cej830/STM32_BLDC_ESC_Firmware/docs/portfolio/author-inputs.md

# 추가 자료와 작성자 입력란

GitHub README는 프로젝트의 구성·동작·결과를 안내합니다. 개인 경험과 취업용 소개는 Notion에 별도로 정리할 수 있습니다. 이 문서는 README에 보완할 자료를 모으는 작성용 문서입니다. 공란은 확인 전까지 그대로 두며, 새 실험은 필수가 아닙니다.

## 1. 대표 사진과 Demo

**사용 위치:** 첫 화면. 만든 보드와 실제 구동을 빠르게 보여주는 자료입니다.

- 실물 사진 파일 또는 경로: ______
- 영상 파일 또는 링크: ______
- 촬영한 보드 버전·날짜: ______
- 영상의 CCR·전원·운전 조건: ______

보드와 모터가 함께 보이는 사진 한 장, 기동 후 노브로 속도를 변경하는 짧은 영상이면 시작할 수 있습니다. RPM을 측정하지 않았다면 속도 변화만 설명합니다.

## 2. PCB·회로와 설계 판단

**사용 위치:** Hardware / System Architecture. 부품 목록에서 더 나아가 설계 의도와 연결 관계를 설명합니다.

- 공개할 KiCad 프로젝트 버전: ______
- 현재 실물 패치가 반영되었는지: ______
- PCB 상·하면 이미지 / 회로도 PDF: ______
- 4층 PCB를 선택한 이유: ______
- 전력 경로·센싱·MCU 배치에서 신경 쓴 부분: ______
- Block diagram에 추가할 신호명·측정점: ______

기존 레이아웃에서 직접 설명할 수 있는 부분만 적습니다. 당시 판단하지 않은 설계 이유를 사후에 만들어 넣지 않습니다.

## 3. USB 문제 해결 증빙

**사용 위치:** Engineering Challenges 1. 풋프린트 오류를 어떻게 식별했는지 구체화합니다.

- MOSFET 부품 번호 / 참조 번호: ______
- 잘못 대응된 핀과 패드: ______
- 오류 확인 방법·관측 내용: ______
- 패치 전후 사진 / 회로 표시: ______
- 적용 후 확인한 연결·리셋 조건: ______

기억나지 않는 조건은 미기록으로 남깁니다. 테스트하지 않은 PC·운영체제에서의 동작을 추가하지 않습니다.

## 4. 고듀티 ZC 문제 해결 증빙

**사용 위치:** Engineering Challenges 2. 입력 파형과 비교기 에지 변화의 관계를 보여줍니다.

- 제거한 Vcom 커패시터 참조 번호·용량: ______
- 변경 전 파형 / 변경 후 파형: ______
- 각 채널 신호와 측정 기준점: ______
- 전원·CCR·모터 조건, 시간·전압 축: ______
- 당시 사용한 firmware 버전 또는 시점: ______

기존 사진이 있다면 먼저 사용합니다. 새로 촬영하면 과거 시험 증거가 아닌 새 시험으로 날짜를 구분합니다. 비교기 에지와 실제 정류 시점을 함께 기록할 수 있으면 제어 흐름 설명에 도움이 됩니다.

## 5. 시험 결과와 로그

**사용 위치:** Test Results. 현재 관찰 기록에 자료를 연결합니다.

- CCR 1750 구동 영상·로그: ______
- 약 1분 운전·PSU 0.6A 표시의 기록 유무: ______
- 당시 초기 온도·측정 온도: ______
- 대표 Monitor 화면 / CSV: ______
- 외부 타코미터 RPM 기록 유무: ______

기록이 없으면 현재 README처럼 개발자 관찰·PSU 표시값으로 유지합니다. 전류 측정 정확도가 확인되기 전에는 션트 CSV를 정확한 전류 성능의 증거로 쓰지 않습니다.

## 6. 빌드와 보드 버전

**사용 위치:** Repository Structure에서 연결하는 재현 문서. 소스와 실제 보드의 대응을 남깁니다.

| 항목 | 사용자 입력 |
| --- | --- |
| STM32CubeIDE 버전 | ______ |
| Compiler / toolchain 버전 | ______ |
| 프로젝트 import·build 절차 | ______ |
| 프로그래머 / 연결 핀 | ______ |
| 보드 revision / 실물 패치 목록 | ______ |
| 시험 firmware commit 또는 보존 파일 | ______ |
| 빌드·다운로드 재현 확인 여부 | ______ |

## 7. References

**사용 위치:** README References 및 상세 문서. 실제 참고한 자료만 기재합니다.

| 자료 | 제목·URL 입력 | 참고 범위 |
| --- | --- | --- |
| MCU 학습 책·블로그 | ______ | 클럭·전원·USB·리셋 주변회로 |
| BLDC ESC 제작 영상·회로 | ______ | 인버터·BEMF·초기 부품 선정 |
| 부품 데이터시트 | ______ | Buck·LDO 등의 예제 회로·배치 |
| TI 평가보드 | ______ | Gerber·PCB 레이아웃 |

## 선택적으로 더할 내용

- **PWM·ADC 동기화 그림:** TIM1 PWM, CH4 trigger, ADC 취득 위치를 한 그림에 표시하면 샘플링 전환 설명에 도움이 됩니다. 사용 가능한 자료: ______
- **기동 상태 전이 로그:** open-loop부터 폐루프 전환까지의 기록이 있으면 Firmware & Control Flow를 보강할 수 있습니다. 자료: ______
- **상용 ESC 비교:** 같은 RPM·초기 온도·운전 시간에서 비교한 결과가 생기면 후속 시험으로 추가합니다. 현재는 미수행으로 유지합니다. 자료: ______

위 항목은 세 번째 문제 해결 사례를 억지로 만들기 위한 목록이 아닙니다. 현재 두 사례로도 구성이 가능하며, 증거와 설명이 있는 항목만 추가합니다.
