cej830/STM32_BLDC_ESC_Firmware/Images/Scope/High Duty.png

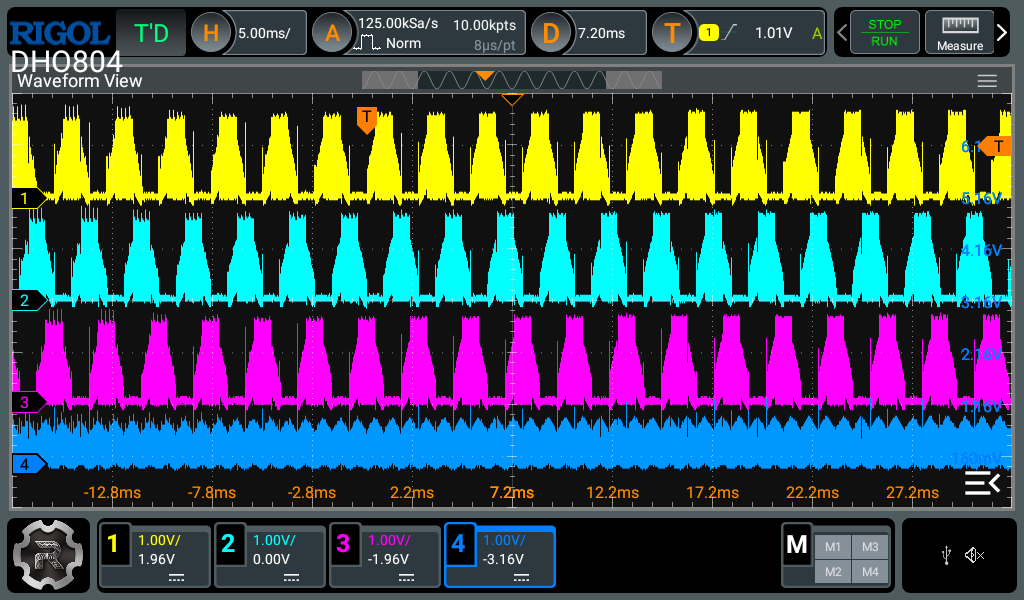
Images/Scope/High Duty.png
