cej830/STM32_BLDC_ESC_Firmware/Images/Scope/Low Duty.png

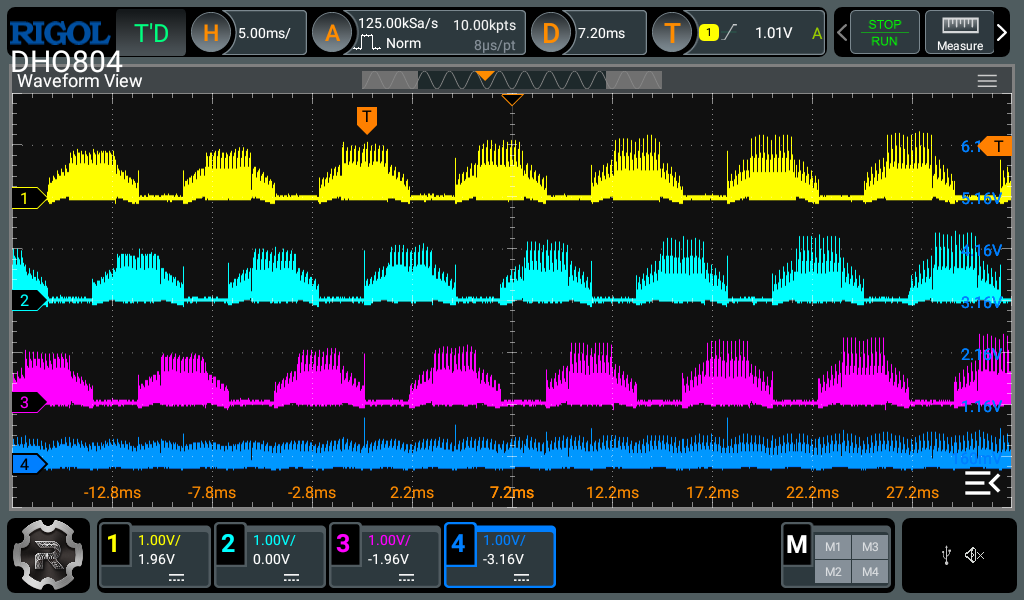
Images/Scope/Low Duty.png
