cej830/STM32_BLDC_ESC_Firmware/Images/Scope/monitor 1400.PNG

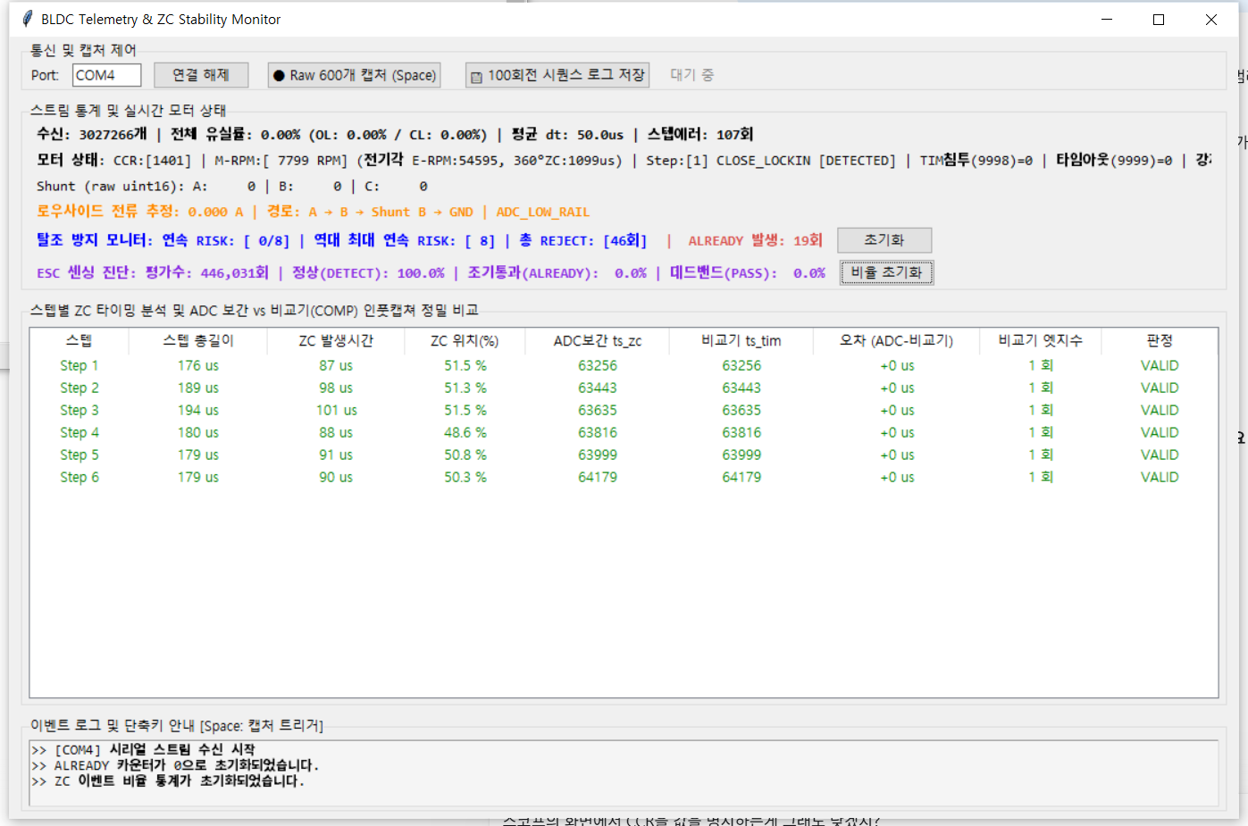
Images/Scope/monitor 1400.PNG
