cej830/STM32_BLDC_ESC_Firmware/HardWare/Manufacturer/STM32_ESC_HW_BOM.csv

# | PKG | Reference | Value | 설명 | Part number | Manufacturer | Qty | Footprint | DNP | Exclude from BOM | Exclude from Board
1 | SMD_D6.3xL7.7mm | C2 | 100uF(AEC) | Aluminum Electrolytic, 100uF, 35V, Low ESR | RVT1V101M0607 | Honor Elec | 1 | Capacitor_SMD:CP_Elec_6.3x7.7
2 | SMD_1206 | C5 | 2.2uF(3216M) | MLCC, 2.2uF, 50V, X7R, ±10% | GRM31CR71H225KA88L | Murata Electronics | 1 | Capacitor_SMD:C_1206_3216Metric
3 | SMD_1206 | C9 | 22uF(3216M) | MLCC, 22uF, 10V, X7R, ±10% | GRM31CR71A226KE15L | Murata Electronics | 1 | Capacitor_SMD:C_1206_3216Metric
4 | SMD_0603 | C14 | 10nF(1608M) | MLCC, 10nF, 50V, X7R, ±10% | CL10B103KB8NNNC | Samsung Electro-Mechanics | 1 | Capacitor_SMD:C_0603_1608Metric
5 | SMD_0805 | C19 | 10uF(2012M) | MLCC, 10uF, 25V, X5R, ±10% | CL21A106KAYNNNE | Samsung Electro-Mechanics | 1 | Capacitor_SMD:C_0805_2012Metric
6 | SMD_D8_L10.2mm | C24 | 220uF(AEC) | Aluminum Electrolytic, 220uF, 35V, Low ESR | RVT1V221M0810 | Honor Elec | 1 | Capacitor_SMD:CP_Elec_8x10.5
7 | SMD_0603 | C1,C3,C6,C8,C11,C13,C15,C17,C25,C26,C27,C31,C32,C33,C34,C35,C39,C40,C41,C42 | 100nF(1608M) | MLCC, 100nF, 50V, X7R, ±10% | GRM188R71H104KA93D | Murata Electronics | 20 | Capacitor_SMD:C_0603_1608Metric
8 | SMD_0603 | C10,C12 | 20pF(1608M) | MLCC, 20pF, 50V, C0G, ±5% | CL10C200JB8NNNC | Samsung Electro-Mechanics | 2 | Capacitor_SMD:C_0603_1608Metric
9 | SMD_0603 | C20,C36,C37,C38 | 1nF(1608M) | MLCC, 1nF, 50V, X7R, ±10% | CL10B102KB8NNNC | Samsung Electro-Mechanics | 4 | Capacitor_SMD:C_0603_1608Metric
10 | SMD_0805 | C21,C22,C23 | 1uF(2012M) | MLCC, 1uF, 25V, X5R, ±10% | CL21B105KAFNFNE | Samsung Electro-Mechanics | 3 | Capacitor_SMD:C_0805_2012Metric
11 | SMD_0603 | C28,C29,C30 | 2.2nF(1608M) | MLCC, 2.2nF, 50V, X7R, ±10% | CL10B222KB8NNNC | Samsung Electro-Mechanics | 3 | Capacitor_SMD:C_0603_1608Metric
12 | SMD_0603 | C4,C7,C16,C18 | 1uF(1608M) | MLCC, 1uF, 25V, X5R, ±10% | CL10A105KA8NNNC | Samsung Electro-Mechanics | 4 | Capacitor_SMD:C_0603_1608Metric
13 | SMD_0603 | D1 | GREEN@5mA | LED, Green, Vf 2.6-3.6V, 20mA, 900mcd | NCD0603G1 | Foshan NationStar Optoelectronics | 1 | LED_SMD:LED_0603_1608Metric
14 | SMD_0603 | D2 | RED@5mA | LED, Red, Vf 1.6-2.6V, 25mA, 220mcd | NCD0603R1 | Foshan NationStar Optoelectronics | 1 | LED_SMD:LED_0603_1608Metric
15 | SMD_0603 | D3 | YELLOW@5mA | LED, Yellow, Vf 1.6-2.6V, 25mA, 60mcd | NCD0603C1 | Foshan NationStar Optoelectronics | 1 | LED_SMD:LED_0603_1608Metric
16 | SMD_0603 | D4 | ORANGE@5mA | LED, Orange, Vf 1.5-2.6V, 25mA, 250mcd | NCD0603O1 | Foshan NationStar Optoelectronics | 1 | LED_SMD:LED_0603_1608Metric
17 | SMD_SOD-323 | D5,D6,D7 | 1SS404 | Scohotty Diode, Vf 0.45V, 300mA, 20V | 1SS404 | Jiangsu Changjing Electronics Technology Co., Ltd. | 3 | Diode_SMD:D_SOD-323
18 | SMD_9.7x5mm | F1 | 0154002.DRT | SMD Fuse with Holder, 2A, 125V, Slow-Blow | 0154002.DRT | Littelfuse | 1 | my_lib:FUSE_154 Series OMNI-BLOK® Fuse and Holder Assembly
19 |  | H1,H2,H3,H4 | MountingHole_Pad | Mounting Hole with connection |  |  | 4 | MountingHole:MountingHole_3.2mm_M3_DIN965_Pad |  | BOM에서 제외됨
20 | TH_Pitch2.54mm_1x4P | J1 | UART | Pin Header, 1x4P, 2.54mm, Male, Vertical | 254PZ-1x4P-V | LXWCONN | 1 | Connector_PinHeader_2.54mm:PinHeader_1x04_P2.54mm_Vertical
21 | SMD_Mini-B | J2 | USB_B_Mini | USB 2.0 Mini-B Receptacle, Female, SMD, Right Angle | 920-462A2021S10101 | Jing Extension of the Electronic Co. | 1 | my_lib:USB_Mini B 920-462A2021S10101
22 | TH_Pitch5.00mm_2P | J3 | PWR | Terminal Block, 2-Pos, Horizontal, 16A, 12-30AWG | 691137710002 | Würth Elektronik | 1 | my_lib:TERM BLK 2POS SIDE ENTRY 5MM PCB
23 | TH_Pitch5.00mm_2P | J4 | Phase A | Terminal Block, 2-Pos, Horizontal, 16A, 12-30AWG | 691137710002 | Würth Elektronik | 1 | my_lib:TERM BLK 2POS SIDE ENTRY 5MM PCB
24 | TH_Pitch5.00mm_2P | J5 | Phase B | Terminal Block, 2-Pos, Horizontal, 16A, 12-30AWG | 691137710002 | Würth Elektronik | 1 | my_lib:TERM BLK 2POS SIDE ENTRY 5MM PCB
25 | TH_Pitch5.00mm_2P | J6 | Phase C | Terminal Block, 2-Pos, Horizontal, 16A, 12-30AWG | 691137710002 | Würth Elektronik | 1 | my_lib:TERM BLK 2POS SIDE ENTRY 5MM PCB
26 | TH_Pitch2.54mm_1x5P | J7 | Conn_01x05 | Pin Header, 1x5P, 2.54mm, Male, Vertical | 2.54-1*5 | ZHOURI | 1 | Connector_PinHeader_2.54mm:PinHeader_1x05_P2.54mm_Vertical
27 | SMD_6x6mm | L1 | 18uH @SMNR6028-180MT | Shielded Power Inductor, 18uH, ±20%, Isat 1.52A, Irms 1.45A, DCR 169mΩ | SMNR6028-180MT | SXN(Shun Xiang Nuo Elec) | 1 | my_lib:Inductor SMNR6028-180MT
28 | SMD_SOT-23 | Q1 | UMW AO3401A (PMOS) | P-MOSFET transistor, gate/source/drain | AO3401A | UMW(Youtai Semiconductor Co., Ltd.) | 1 | Package_TO_SOT_SMD:SOT-23
29 | SMD_0603 | R2 | 1.8k(1608M) | Thick Film Resistor, 1.8kΩ, 1/10W, ±1% | 0603WAJ0182T5E | UNI-ROYAL(Uniroyal Elec) | 1 | Resistor_SMD:R_0603_1608Metric
30 | SMD_0603 | R6 | 88.7k(1608M) | Thick Film Resistor, 88.7kΩ, 1/10W, ±1% | 0603WAF8872T5E | UNI-ROYAL(Uniroyal Elec) | 1 | Resistor_SMD:R_0603_1608Metric
31 | SMD_0603 | R7 | 22.1k(1608M) | Thick Film Resistor, 22.1kΩ, 1/10W, ±1% | 0603WAF2212T5E | UNI-ROYAL(Uniroyal Elec) | 1 | Resistor_SMD:R_0603_1608Metric
32 | SMD_0603 | R9 | 0(1608M) | Thick Film Resistor, 0Ω, 1/10W, ±1% | 0603WAF0000T5E | UNI-ROYAL(Uniroyal Elec) | 1 | Resistor_SMD:R_0603_1608Metric
33 | SMD_0603 | R57 | 1.5k(1608M) | Thick Film Resistor, 1.5kΩ, 1/10W, ±1% | 0603WAF1501T5E | UNI-ROYAL(Uniroyal Elec) | 1 | Resistor_SMD:R_0603_1608Metric
34 | SMD_0603 | R1,R59 | 330(1608M) | Thick Film Resistor, 330Ω, 1/10W, ±1% | 0603WAF3300T5E | UNI-ROYAL(Uniroyal Elec) | 2 | Resistor_SMD:R_0603_1608Metric
35 | SMD_0603 | R10,R11,R12 | 33(1608M) | Thick Film Resistor, 33Ω, 1/10W, ±1% | 0603WAF330JT5E | UNI-ROYAL(Uniroyal Elec) | 3 | Resistor_SMD:R_0603_1608Metric
36 | SMD_0603 | R16,R19,R23 | 2k(1608M) | Thick Film Resistor, 2kΩ, 1/10W, ±1% | 0603WAF2001T5E | UNI-ROYAL(Uniroyal Elec) | 3 | Resistor_SMD:R_0603_1608Metric
37 | SMD_0603 | R17,R18,R27,R28,R32,R33 | 47(1608M) | Thick Film Resistor, 47Ω, 1/10W, ±1% | 0603WAF470JT5E | UNI-ROYAL(Uniroyal Elec) | 6 | Resistor_SMD:R_0603_1608Metric
38 | SMD_2512 | R22,R31,R36 | 10m(6332M) | Current Sense Metal Film Resistor, 10mΩ, 2W, ±1%, ±50ppm/℃ | PE2512FKE7W0R01Z | YAGEO | 3 | my_lib:Shunt_R_PE2512_7m-910m Ohm_SMD_2512
39 | SMD_0603 | R3,R4,R5 | 270(1608M) | Thick Film Resistor, 270Ω, 1/10W, ±5% | 0603WAJ0271T5E | UNI-ROYAL(Uniroyal Elec) | 3 | Resistor_SMD:R_0603_1608Metric
40 | SMD_0603 | R41,R42,R43 | 1k(1608M) | Thick Film Resistor, 1kΩ, 1/10W, ±1% | 0603WAF1001T5E | UNI-ROYAL(Uniroyal Elec) | 3 | Resistor_SMD:R_0603_1608Metric
41 | TH_ALPS_RK09K | R48,R50 | 10k(pot THT) | Rotary Potentiometer, 10kΩ, ±20%, Linear , Top Adjust, TH | RK09K1130AAU | ALPSALPINE | 2 | my_lib:Potentiometer_Alps_RK09K_Single_Vertical
42 | SMD_0603 | R53,R54,R55,R56 | 22(1608M) | Thick Film Resistor, 22Ω, 1/10W, ±1% | 0603WAF220JT5E | UNI-ROYAL(Uniroyal Elec) | 4 | Resistor_SMD:R_0603_1608Metric
43 | SMD_0603 | R8,R13,R14,R15,R20,R21,R24,R25,R26,R29,R30,R34,R35,R37,R38,R39,R40,R44,R45,R46,R47,R49,R51,R52,R58 | 10k(1608M) | Thick Film Resistor, 10kΩ, 1/10W, ±1% | 0603WAF1002T5E | UNI-ROYAL(Uniroyal Elec) | 25 | Resistor_SMD:R_0603_1608Metric
44 | SMD_4P_6x6mm | SW1,SW2,SW3 | SW_SPST | Tactile Switch, SPST, 12V 50mA, 1.6N, H=5mm | UK-B0228-G5-160-JZ | USAKRO | 3 | my_lib:Button_Switch_SMD SW_Push_1P1T SMD-4P,6x6mm
45 | TH_3.2mm | TP12 | 5121 G | Test Ring, Green | RH-5121 | ronghe | 1 | TestPoint:TestPoint_Keystone_5005-5009_Compact
46 | TH_3.2mm | TP1,TP2,TP3,TP4 | 5006 Blk | Test Ring, Black | RH-5006 | ronghe | 4 | TestPoint:TestPoint_Keystone_5005-5009_Compact
47 | TH_3.2mm | TP10,TP14,TP17 | 5008 Or | Test Ring, Orange,Test Ring, Red | RH-5005,RH-5008 | ronghe | 3 | TestPoint:TestPoint_Keystone_5005-5009_Compact
48 | TH_3.2mm | TP11,TP15,TP18 | 5009 Y | Test Ring, Red,Test Ring, Yellow | RH-5005,RH-5009 | ronghe | 3 | TestPoint:TestPoint_Keystone_5005-5009_Compact
49 | TH_3.2mm | TP5,TP6,TP7,TP8 | TestPoint@(5122 B) | Test Ring, Blue | RH-5122 | ronghe | 4 | TestPoint:TestPoint_Keystone_5005-5009_Compact
50 | TH_3.2mm | TP9,TP13,TP16 | 5005 R | Test Ring, Red | RH-5005 | ronghe | 3 | TestPoint:TestPoint_Keystone_5005-5009_Compact
51 | SMD_SMB(DO-214AA) | TVS1 | SMBJ13A | TVS Diode, Unidirectional, Vrwm 13V, Vbr 15.2V, Vcl 27.2V, 4kW | SMBJ13A-TR | STMicroelectronics | 1 | my_lib:TVS_Diode_SMD_SMB(DO-214AA)
52 | SMD_SOT-23-5 | U1 | TPS7A2033PDBVR | LDO Regulator, Fixed 3.3V, Vin max 6V, 300mA, Vdrop 140mV | TPS7A2033PDBVR | Texas Instruments | 1 | Package_TO_SOT_SMD:SOT-23-5
53 | SMD_SOT-23-6 | U2 | TPS560430XDBVR | Buck Converter, Adj, Vin 4-36V, 600mA, 1.1MHz | TPS560430XDBVR | Texas Instruments | 1 | my_lib:SOT-23-6(2.90 mm × 1.60 mm)
54 | SMD_LQFP-48 | U3 | STM32F103C8Tx | MCU, ARM Cortex-M3, 32bit, 72MHz, 64KB Flash, 20KB SRAM | STM32F103C8T6 | STMicroelectronics | 1 | Package_QFP:LQFP-48_7x7mm_P0.5mm
55 | SMD_TSSOP-20 | U4 | DRV8300DPWR | Gate Driver, 3-Phase BLDC, 100V, 750mA/1.5A Source/Sink, 5V-20V VDD | DRV8300DPWR | Texas Instruments | 1 | my_lib:DRV8300DPWR 20-TSSOP 6.6mm _ 4.5mm
56 | SMD_SOIC-8 | U11,U12 | TLV3202AIDR | Dual Comparator, 2.7-5V, 40ns High Speed, Push-Pull, Rail-to-Rail | TLV3202AIDR | Texas Instruments | 2 | Package_SO:SOIC-8_3.9x4.9mm_P1.27mm
57 | SMD_SOT-23-5 | U13,U14,U15 | INA180A3 | Current Sense Amplifier, Gain 100V/V, CMRR 100dB, 2.7V-5.5V | INA180A3IDBVR | Texas Instruments | 3 | Package_TO_SOT_SMD:SOT-23-5
58 | SMD_SOT-23-6 | U16,U17 | USBLC6-2SC6 | TVS Diode Array, 2-Channel Vrwm 5V, Vbr 6V, Vcl 15V, 150W | USBLC6-2SC6 | UMW(Youtai Semiconductor Co., Ltd.) | 2 | Package_TO_SOT_SMD:SOT-23-6
59 | SMD_PQFN5x6-8 | U5,U6,U7,U8,U9,U10 | IRFH7440TRPBF | N-Channel MOSFET, 40V, 1.8mΩ@10V, Qg 96nC | IRFH7440TRPBF | Infineon Technologies | 6 | Package_DFN_QFN:PQFN-8-EP_6x5mm_P1.27mm_Generic
60 | SMD_HC-49S | Y1 | 8MHz @ 20pF | Crystal, 8MHz, 20pF, ±20ppm, ESR 70Ω | X49SM8MSD2SC | YXC Crystal Oscillators | 1 | Crystal:Crystal_SMD_HC49-SD
