cej830/STM32_BLDC_ESC_Firmware/Images/Demo/motor-operation.jpg

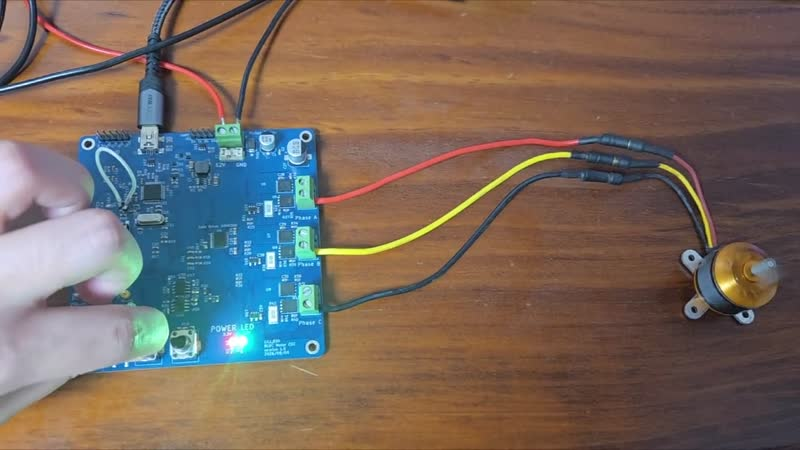
Images/Demo/motor-operation.jpg
