cej830/STM32_BLDC_ESC_Firmware/HardWare/STM32_ESC_HW.kicad_pcb

## KiCad design HardWare/STM32_ESC_HW.kicad_pcb (2026-10-27)

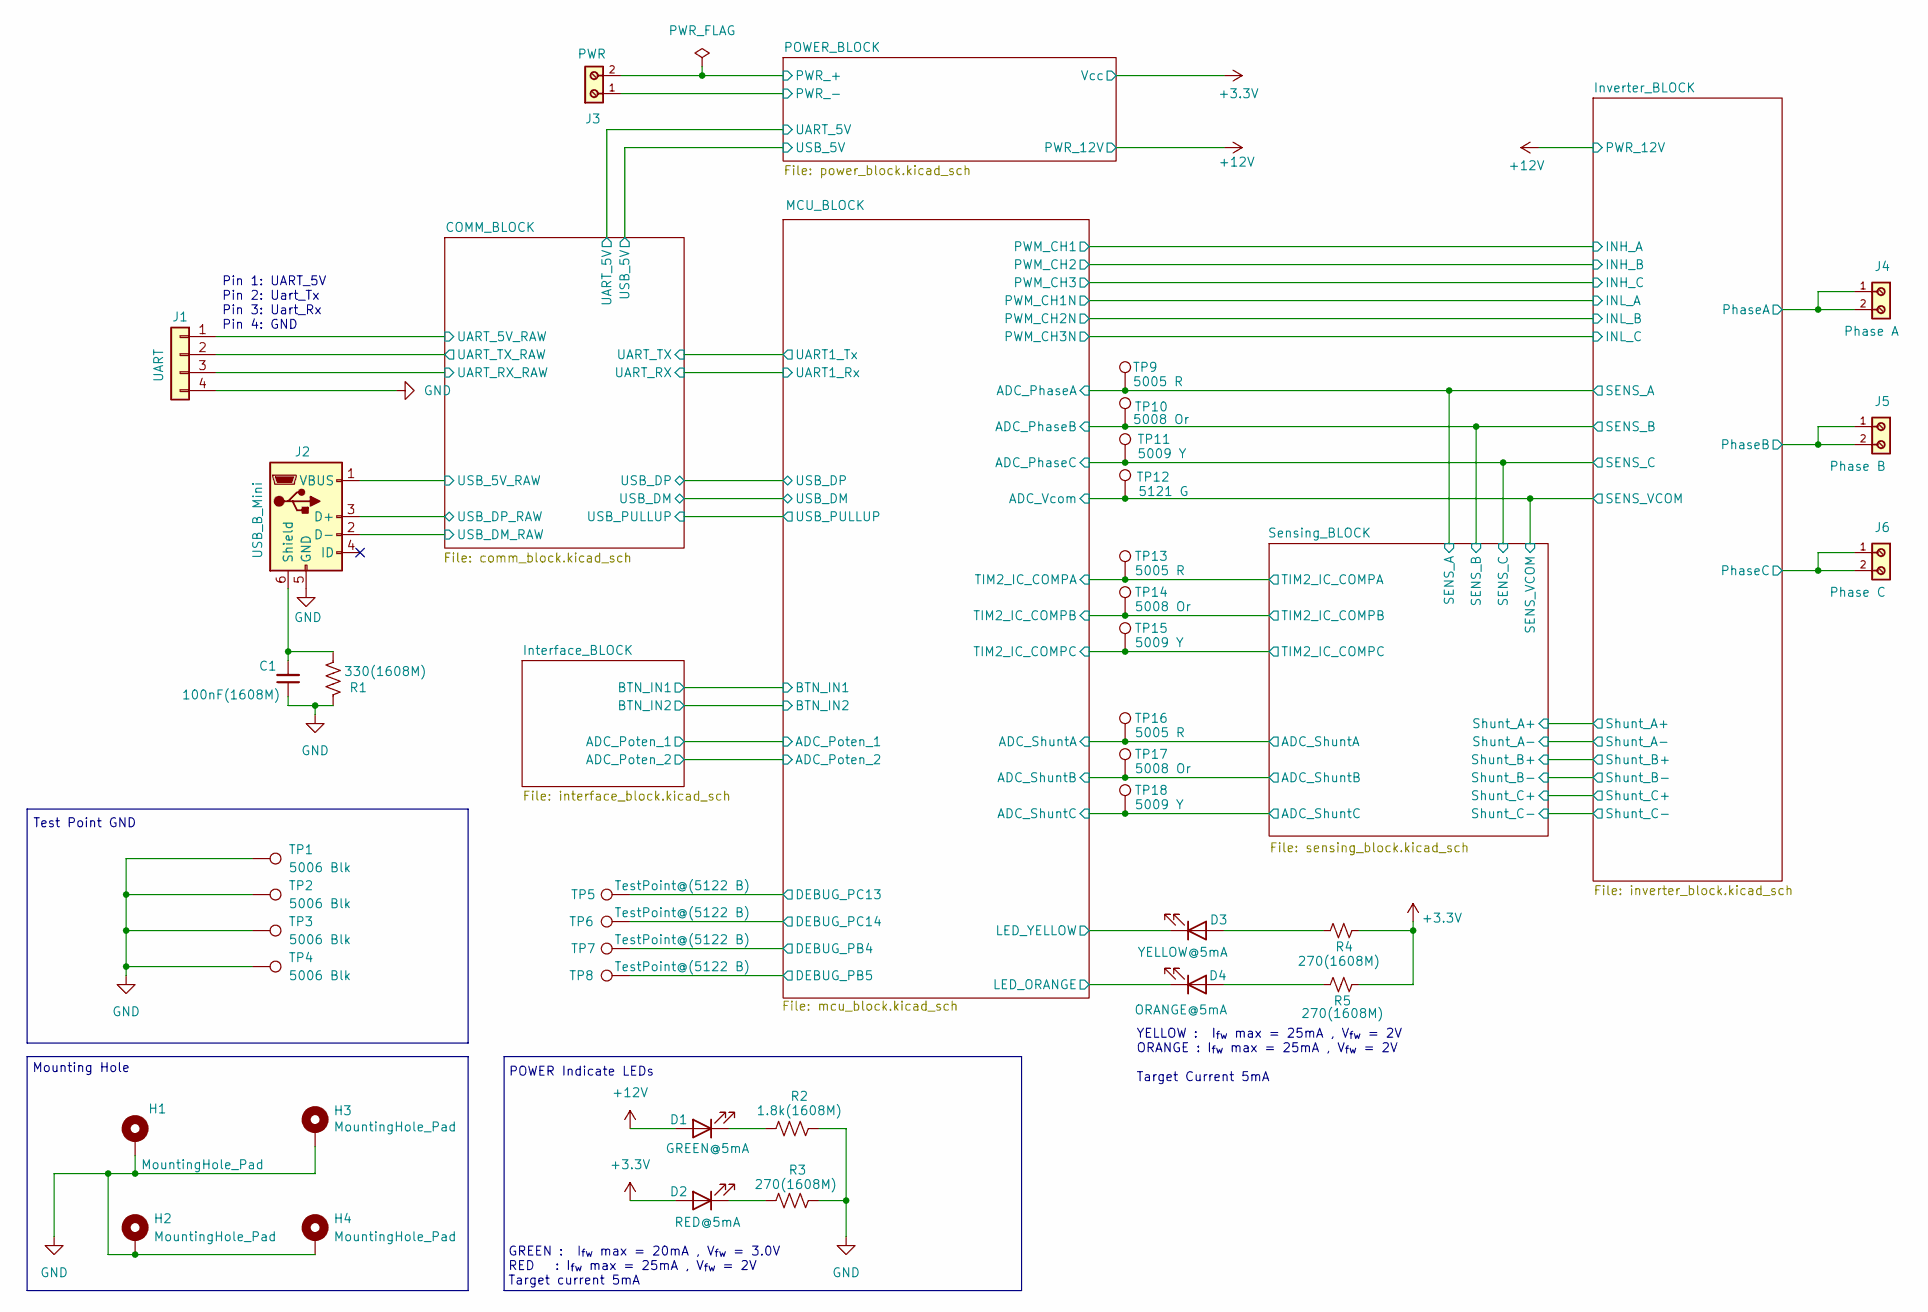
[picture p20: schematic STM32_ESC_HW.kicad_sch, BLDC Motor ESC]

Parts:
C1: 100nF(1608M); C_0603_1608Metric; Part number GRM188R71H104KA93D
D1: GREEN@5mA; LED_0603_1608Metric; Part number NCD0603G1
D2: RED@5mA; LED_0603_1608Metric; Part number NCD0603R1
D3: YELLOW@5mA; LED_0603_1608Metric; Part number NCD0603C1
D4: ORANGE@5mA; LED_0603_1608Metric; Part number NCD0603O1
H1, H2, H3, H4: MountingHole_Pad; MountingHole_3.2mm_M3_DIN965_Pad
J1: UART; PinHeader_1x04_P2.54mm_Vertical; Part number 254PZ-1x4P-V
J2: USB_B_Mini; USB_Mini B 920-462A2021S10101; Part number 920-462A2021S10101
J3: PWR; TERM BLK 2POS SIDE ENTRY 5MM PCB; Part number 691137710002
J4: Phase A; TERM BLK 2POS SIDE ENTRY 5MM PCB; Part number 691137710002
J5: Phase B; TERM BLK 2POS SIDE ENTRY 5MM PCB; Part number 691137710002
J6: Phase C; TERM BLK 2POS SIDE ENTRY 5MM PCB; Part number 691137710002
R1: 330(1608M); R_0603_1608Metric; Part number 0603WAF3300T5E
R2: 1.8k(1608M); R_0603_1608Metric; Part number 0603WAJ0182T5E
R3, R4, R5: 270(1608M); R_0603_1608Metric; Part number 0603WAJ0271T5E
TP1, TP2, TP3, TP4: 5006 Blk; TestPoint_Keystone_5005-5009_Compact; Part number RH-5006
TP5, TP6, TP7, TP8: TestPoint@(5122 B); TestPoint_Keystone_5005-5009_Compact; Part number RH-5122
TP9, TP13, TP16: 5005 R; TestPoint_Keystone_5005-5009_Compact; Part number RH-5005
TP10: 5008 Or; TestPoint_Keystone_5005-5009_Compact; Part number RH-5008
TP11: 5009 Y; TestPoint_Keystone_5005-5009_Compact; Part number RH-5009
TP12: 5121 G; TestPoint_Keystone_5005-5009_Compact; Part number RH-5121
TP14, TP17: 5008 Or; TestPoint_Keystone_5005-5009_Compact; Part number RH-5005
TP15, TP18: 5009 Y; TestPoint_Keystone_5005-5009_Compact; Part number RH-5005

Connections:
+3.3V: D2.2 (A), R4.2, R5.2; also elsewhere on the board
+12V: D1.2 (A); also elsewhere on the board
/COMM_BLOCK/UART_RX_RAW: J1.3; also elsewhere on the board
/COMM_BLOCK/UART_TX_RAW: J1.2; also elsewhere on the board
/COMM_BLOCK/USB_D_N: J2.2 (D-); also elsewhere on the board
/COMM_BLOCK/USB_D_P: J2.3 (D+); also elsewhere on the board
/Inverter_BLOCK/PhaseA: J4.1, J4.2; also elsewhere on the board
/Inverter_BLOCK/PhaseB: J5.1, J5.2; also elsewhere on the board
/Inverter_BLOCK/PhaseC: J6.1, J6.2; also elsewhere on the board
/Inverter_BLOCK/SENS_A: TP9.1; also elsewhere on the board
/Inverter_BLOCK/SENS_B: TP10.1; also elsewhere on the board
/Inverter_BLOCK/SENS_C: TP11.1; also elsewhere on the board
/Inverter_BLOCK/SENS_VCOM: TP12.1; also elsewhere on the board
/MCU_BLOCK/ADC_ShuntA: TP16.1; also elsewhere on the board
/MCU_BLOCK/ADC_ShuntB: TP17.1; also elsewhere on the board
/MCU_BLOCK/ADC_ShuntC: TP18.1; also elsewhere on the board
/MCU_BLOCK/DEBUG_PB4: TP7.1; also elsewhere on the board
/MCU_BLOCK/DEBUG_PB5: TP8.1; also elsewhere on the board
/MCU_BLOCK/DEBUG_PC13: TP5.1; also elsewhere on the board
/MCU_BLOCK/DEBUG_PC14: TP6.1; also elsewhere on the board
/MCU_BLOCK/LED_ORANGE: D4.1 (K); also elsewhere on the board
/MCU_BLOCK/LED_YELLOW: D3.1 (K); also elsewhere on the board
/MCU_BLOCK/TIM2_IC_COMPA: TP13.1; also elsewhere on the board
/MCU_BLOCK/TIM2_IC_COMPB: TP14.1; also elsewhere on the board
/MCU_BLOCK/TIM2_IC_COMPC: TP15.1; also elsewhere on the board
/POWER_BLOCK/PWR_+: J3.2; also elsewhere on the board
/POWER_BLOCK/UART_5V: J1.1; also elsewhere on the board
/POWER_BLOCK/USB_5V: J2.1 (VBUS); also elsewhere on the board
GND: C1.1, H1.1, H2.1, H3.1, H4.1, J1.4, J2.5 (GND), J3.1, R1.1, R2.2, R3.2, TP1.1, TP2.1, TP3.1, TP4.1; also elsewhere on the board
unnamed: D1.1 (K), R2.1
unnamed: D2.1 (K), R3.1
unnamed: D3.2 (A), R4.1
unnamed: D4.2 (A), R5.1
unnamed: C1.2, J2.6 (Shield), R1.2

Notes on the sheet:
YELLOW : I_{fw} max = 25mA , V_{fw} = 2V ORANGE : I_{fw} max = 25mA , V_{fw} = 2V Target Current 5mA
GREEN : I_{fw} max = 20mA , V_{fw} = 3.0V RED : I_{fw} max = 25mA , V_{fw} = 2V Target current 5mA
Mounting Hole
Test Point GND
POWER Indicate LEDs
Pin 1: UART_5V Pin 2: Uart_Tx Pin 3: Uart_Rx Pin 4: GND

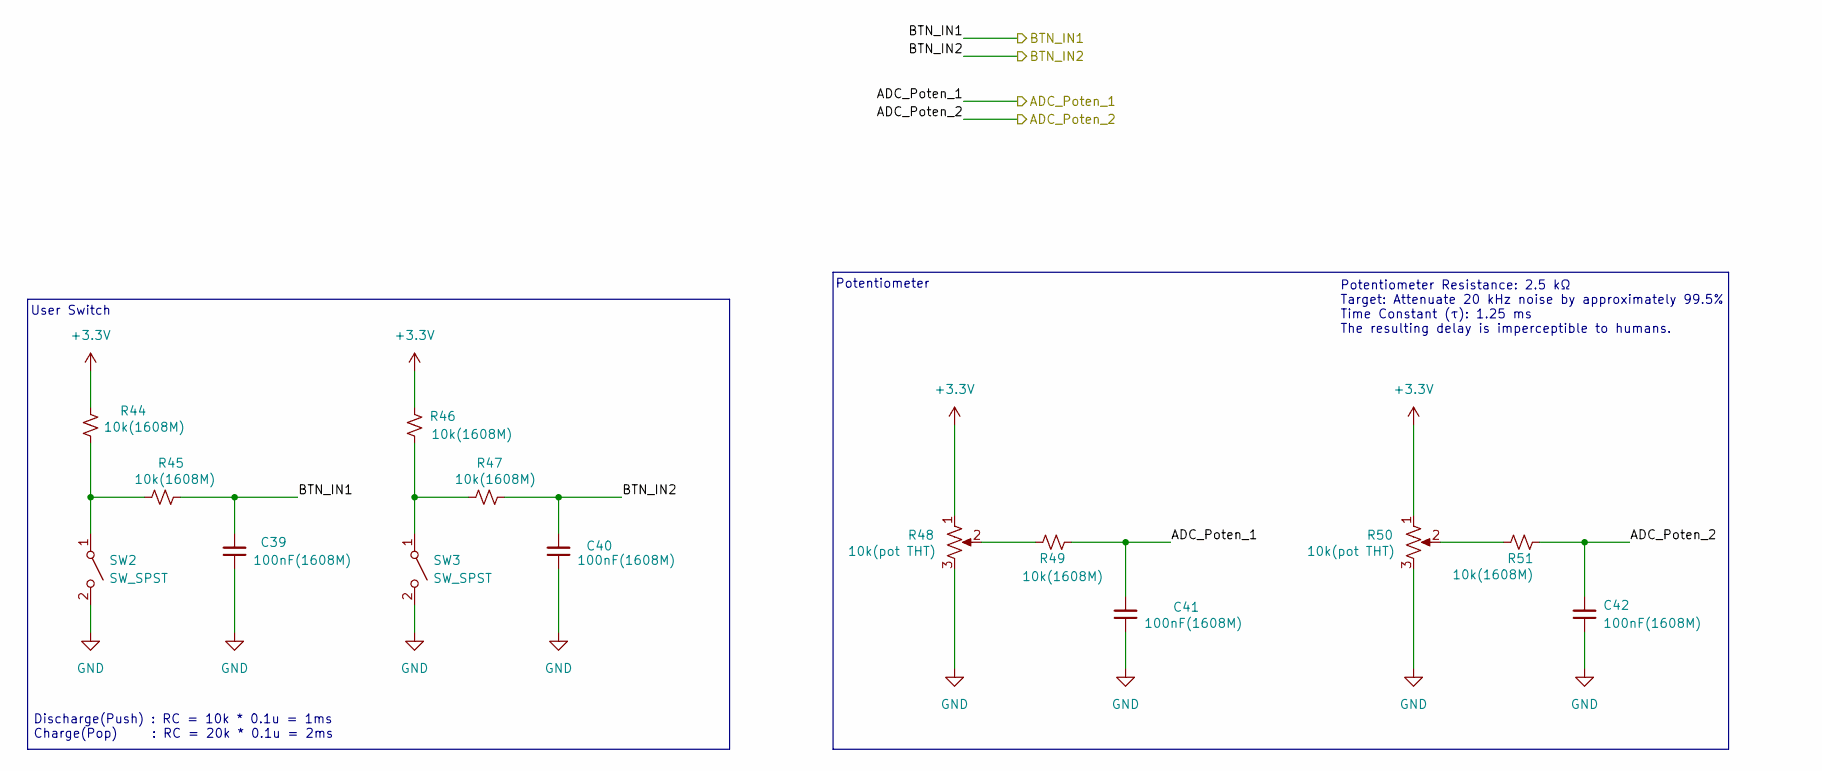
[picture p21: schematic interface_block.kicad_sch, BLDC Motor ESC]

Parts:
C39, C40, C41, C42: 100nF(1608M); C_0603_1608Metric; Part number GRM188R71H104KA93D
R44, R45, R46, R47, R49, R51: 10k(1608M); R_0603_1608Metric; Part number 0603WAF1002T5E
R48, R50: 10k(pot THT); Potentiometer_Alps_RK09K_Single_Vertical; Part number RK09K1130AAU
SW2, SW3: SW_SPST; Button_Switch_SMD SW_Push_1P1T SMD-4P,6x6mm; Part number UK-B0228-G5-160-JZ

Connections:
+3.3V: R44.1, R46.1, R48.1, R50.1; also elsewhere on the board
/Interface_BLOCK/ADC_Poten_1: C41.2, R49.2; also elsewhere on the board
/Interface_BLOCK/ADC_Poten_2: C42.2, R51.2; also elsewhere on the board
/Interface_BLOCK/BTN_IN1: C39.2, R45.1; also elsewhere on the board
/Interface_BLOCK/BTN_IN2: C40.2, R47.1; also elsewhere on the board
GND: C39.1, C40.1, C41.1, C42.1, R48.3, R50.3, SW2.2 (B), SW3.2 (B); also elsewhere on the board
unnamed: R48.2, R49.1
unnamed: R50.2, R51.1
unnamed: R44.2, R45.2, SW2.1 (A)
unnamed: R46.2, R47.2, SW3.1 (A)

Notes on the sheet:
Potentiometer
User Switch
Discharge(Push) : RC = 10k * 0.1u = 1ms Charge(Pop) : RC = 20k * 0.1u = 2ms
Potentiometer Resistance: 2.5 kΩ Target: Attenuate 20 kHz noise by approximately 99.5% Time Constant (τ): 1.25 ms The resulting delay is imperceptible to humans.

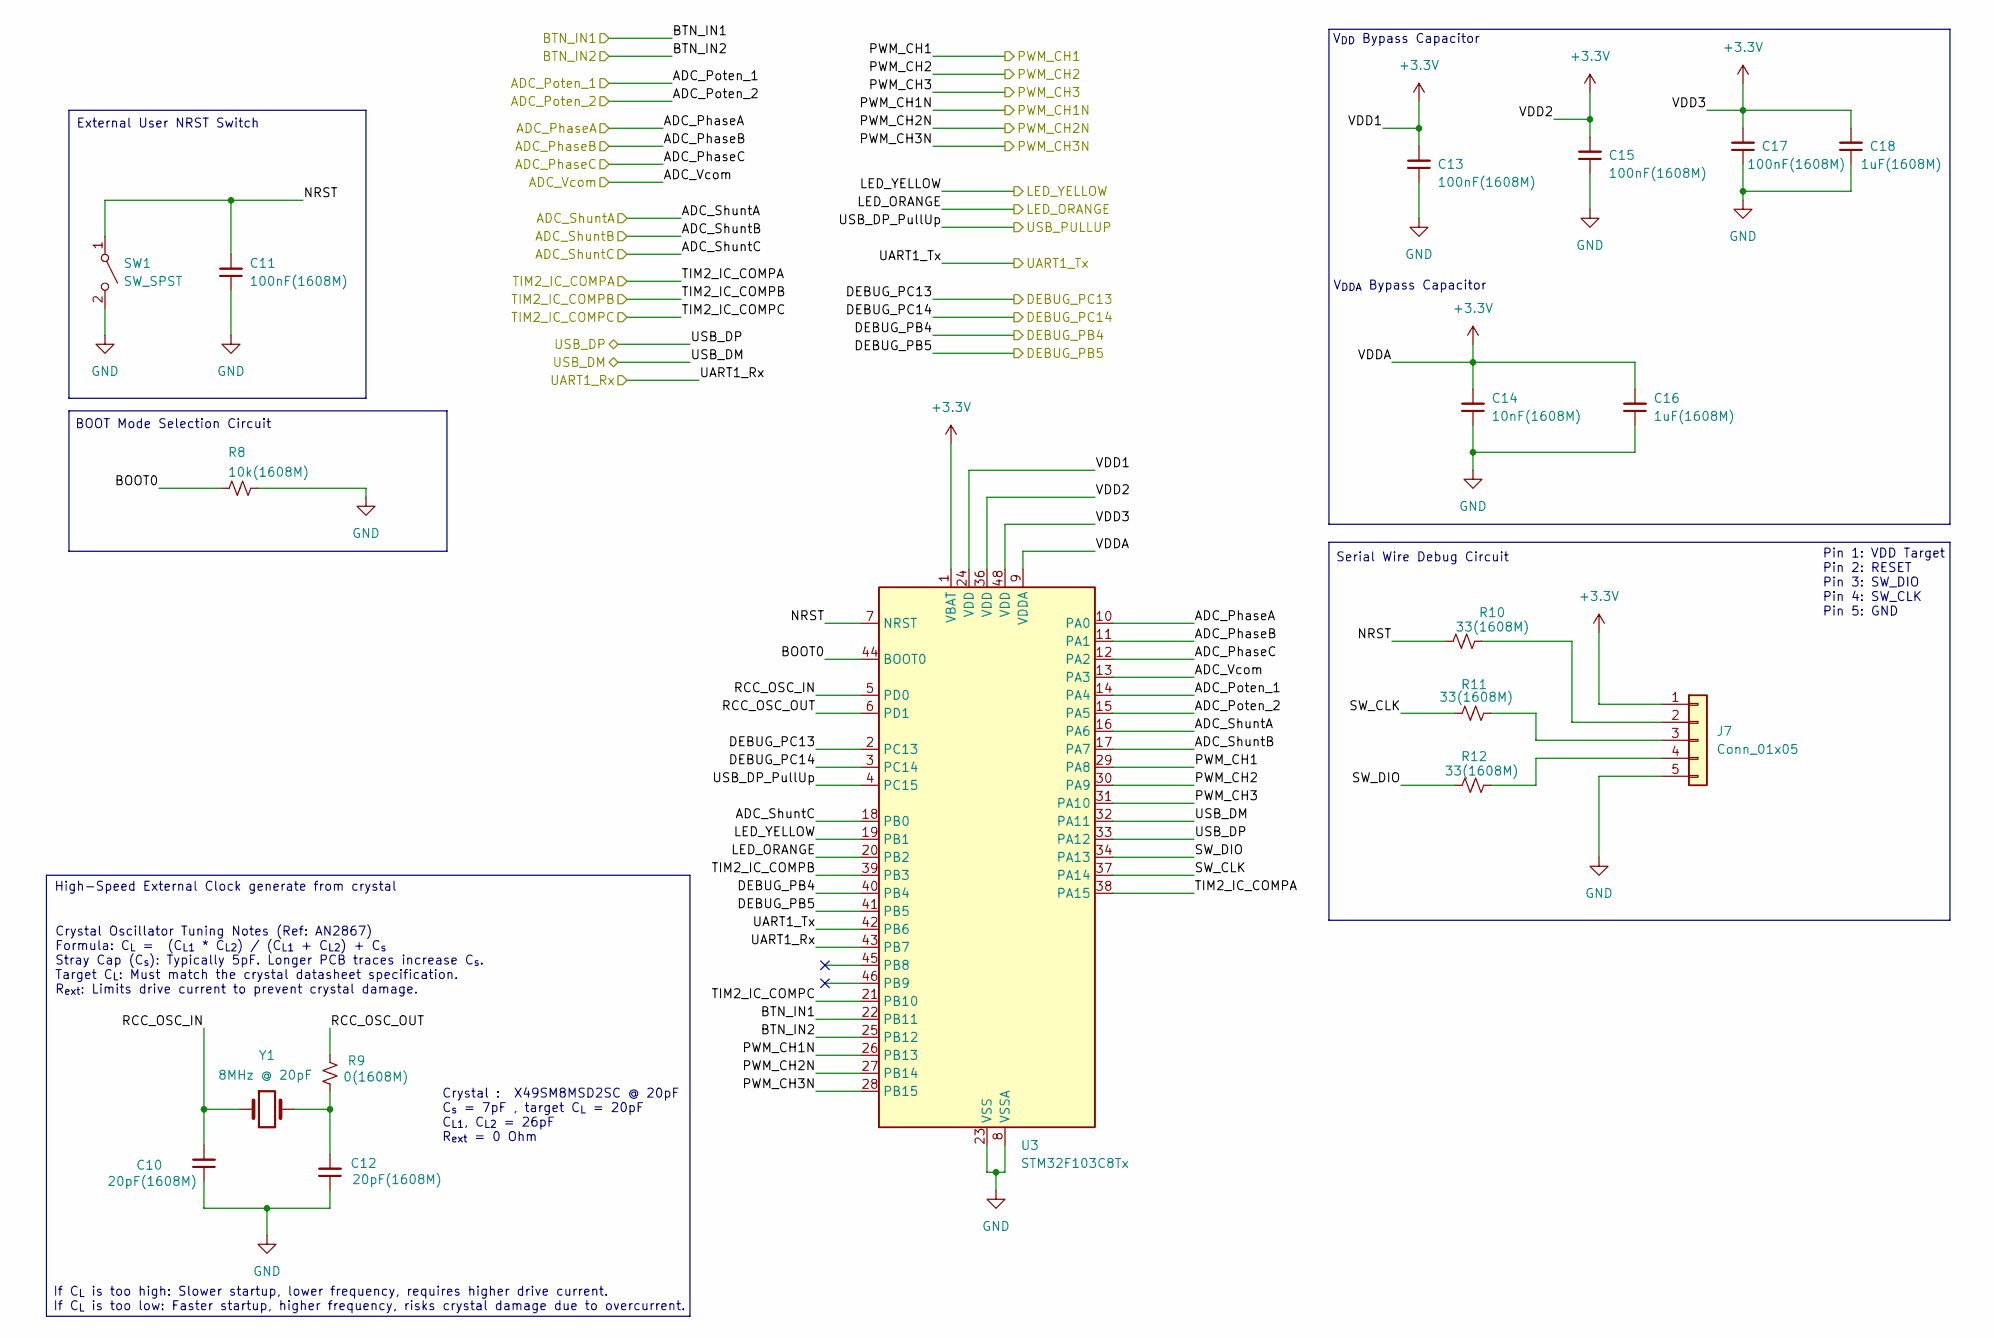
[picture p22: schematic mcu_block.kicad_sch, BLDC Motor ESC]

Parts:
C10, C12: 20pF(1608M); C_0603_1608Metric; Part number CL10C200JB8NNNC
C11, C13, C15, C17: 100nF(1608M); C_0603_1608Metric; Part number GRM188R71H104KA93D
C14: 10nF(1608M); C_0603_1608Metric; Part number CL10B103KB8NNNC
C16, C18: 1uF(1608M); C_0603_1608Metric; Part number CL10A105KA8NNNC
J7: Conn_01x05; PinHeader_1x05_P2.54mm_Vertical; Part number 2.54-1*5
R8: 10k(1608M); R_0603_1608Metric; Part number 0603WAF1002T5E
R9: 0(1608M); R_0603_1608Metric; Part number 0603WAF0000T5E
R10, R11, R12: 33(1608M); R_0603_1608Metric; Part number 0603WAF330JT5E
SW1: SW_SPST; Button_Switch_SMD SW_Push_1P1T SMD-4P,6x6mm; Part number UK-B0228-G5-160-JZ
U3: STM32F103C8Tx; LQFP-48_7x7mm_P0.5mm; Part number STM32F103C8T6
Y1: 8MHz @ 20pF; Crystal_SMD_HC49-SD; Partnum# C12674

Connections:
+3.3V: C13.2, C14.2, C15.2, C16.2, C17.2, C18.2, J7.1, U3.1 (VBAT), U3.9 (VDDA), U3.24 (VDD), U3.36 (VDD), U3.48 (VDD); also elsewhere on the board
/COMM_BLOCK/USB_+: U3.33 (PA12); also elsewhere on the board
/COMM_BLOCK/USB_-: U3.32 (PA11); also elsewhere on the board
/Interface_BLOCK/ADC_Poten_1: U3.14 (PA4); also elsewhere on the board
/Interface_BLOCK/ADC_Poten_2: U3.15 (PA5); also elsewhere on the board
/Interface_BLOCK/BTN_IN1: U3.22 (PB11); also elsewhere on the board
/Interface_BLOCK/BTN_IN2: U3.25 (PB12); also elsewhere on the board
/Inverter_BLOCK/SENS_A: U3.10 (PA0); also elsewhere on the board
/Inverter_BLOCK/SENS_B: U3.11 (PA1); also elsewhere on the board
/Inverter_BLOCK/SENS_C: U3.12 (PA2); also elsewhere on the board
/Inverter_BLOCK/SENS_VCOM: U3.13 (PA3); also elsewhere on the board
/MCU_BLOCK/ADC_ShuntA: U3.16 (PA6); also elsewhere on the board
/MCU_BLOCK/ADC_ShuntB: U3.17 (PA7); also elsewhere on the board
/MCU_BLOCK/ADC_ShuntC: U3.18 (PB0); also elsewhere on the board
/MCU_BLOCK/BOOT0: R8.2, U3.44 (BOOT0)
/MCU_BLOCK/DEBUG_PB4: U3.40 (PB4); also elsewhere on the board
/MCU_BLOCK/DEBUG_PB5: U3.41 (PB5); also elsewhere on the board
/MCU_BLOCK/DEBUG_PC13: U3.2 (PC13); also elsewhere on the board
/MCU_BLOCK/DEBUG_PC14: U3.3 (PC14); also elsewhere on the board
/MCU_BLOCK/LED_ORANGE: U3.20 (PB2); also elsewhere on the board
/MCU_BLOCK/LED_YELLOW: U3.19 (PB1); also elsewhere on the board
/MCU_BLOCK/NRST: C11.2, R10.2, SW1.1 (A), U3.7 (NRST)
/MCU_BLOCK/PWM_CH1: U3.29 (PA8); also elsewhere on the board
/MCU_BLOCK/PWM_CH1N: U3.26 (PB13); also elsewhere on the board
/MCU_BLOCK/PWM_CH2: U3.30 (PA9); also elsewhere on the board
/MCU_BLOCK/PWM_CH2N: U3.27 (PB14); also elsewhere on the board
/MCU_BLOCK/PWM_CH3: U3.31 (PA10); also elsewhere on the board
/MCU_BLOCK/PWM_CH3N: U3.28 (PB15); also elsewhere on the board
/MCU_BLOCK/RCC_OSC_IN: C10.2, U3.5 (PD0), Y1.1
/MCU_BLOCK/RCC_OSC_OUT: R9.2, U3.6 (PD1)
/MCU_BLOCK/SW_CLK: R11.2, U3.37 (PA14)
/MCU_BLOCK/SW_DIO: R12.2, U3.34 (PA13)
/MCU_BLOCK/TIM2_IC_COMPA: U3.38 (PA15); also elsewhere on the board
/MCU_BLOCK/TIM2_IC_COMPB: U3.39 (PB3); also elsewhere on the board
/MCU_BLOCK/TIM2_IC_COMPC: U3.21 (PB10); also elsewhere on the board
/MCU_BLOCK/UART1_Rx: U3.43 (PB7); also elsewhere on the board
/MCU_BLOCK/UART1_Tx: U3.42 (PB6); also elsewhere on the board
/MCU_BLOCK/USB_DP_PullUp: U3.4 (PC15); also elsewhere on the board
GND: C10.1, C11.1, C12.1, C13.1, C14.1, C15.1, C16.1, C17.1, C18.1, J7.5, R8.1, SW1.2 (B), U3.8 (VSSA), U3.23 (VSS), U3.35 (VSS), U3.47 (VSS); also elsewhere on the board
unnamed: C12.2, R9.1, Y1.2
unnamed: J7.2, R10.1
unnamed: J7.3, R11.1
unnamed: J7.4, R12.1

Notes on the sheet:
External User NRST Switch
Serial Wire Debug Circuit
High-Speed External Clock generate from crystal
Pin 1: VDD Target Pin 2: RESET Pin 3: SW_DIO Pin 4: SW_CLK Pin 5: GND
Crystal : X49SM8MSD2SC @ 20pF C_{s} = 7pF , target C_{L} = 20pF C_{L1}, C_{L2} = 26pF R_{ext} = 0 Ohm
V_{DD} Bypass Capacitor
V_{DDA} Bypass Capacitor
Crystal Oscillator Tuning Notes (Ref: AN2867) Formula: C_{L} = (C_{L1} * C_{L2}) / (C_{L1} + C_{L2}) + C_{s} Stray Cap (C_{s}): Typically 5pF. Longer PCB traces increase C_{s}. Target C_{L}: Must match the crystal datasheet specification. R_{ext}: Limits drive current to prevent crystal damage.
If C_{L} is too high: Slower startup, lower frequency, requires higher drive current. If C_{L} is too low: Faster startup, higher frequency, risks crystal damage due to overcurrent.
BOOT Mode Selection Circuit

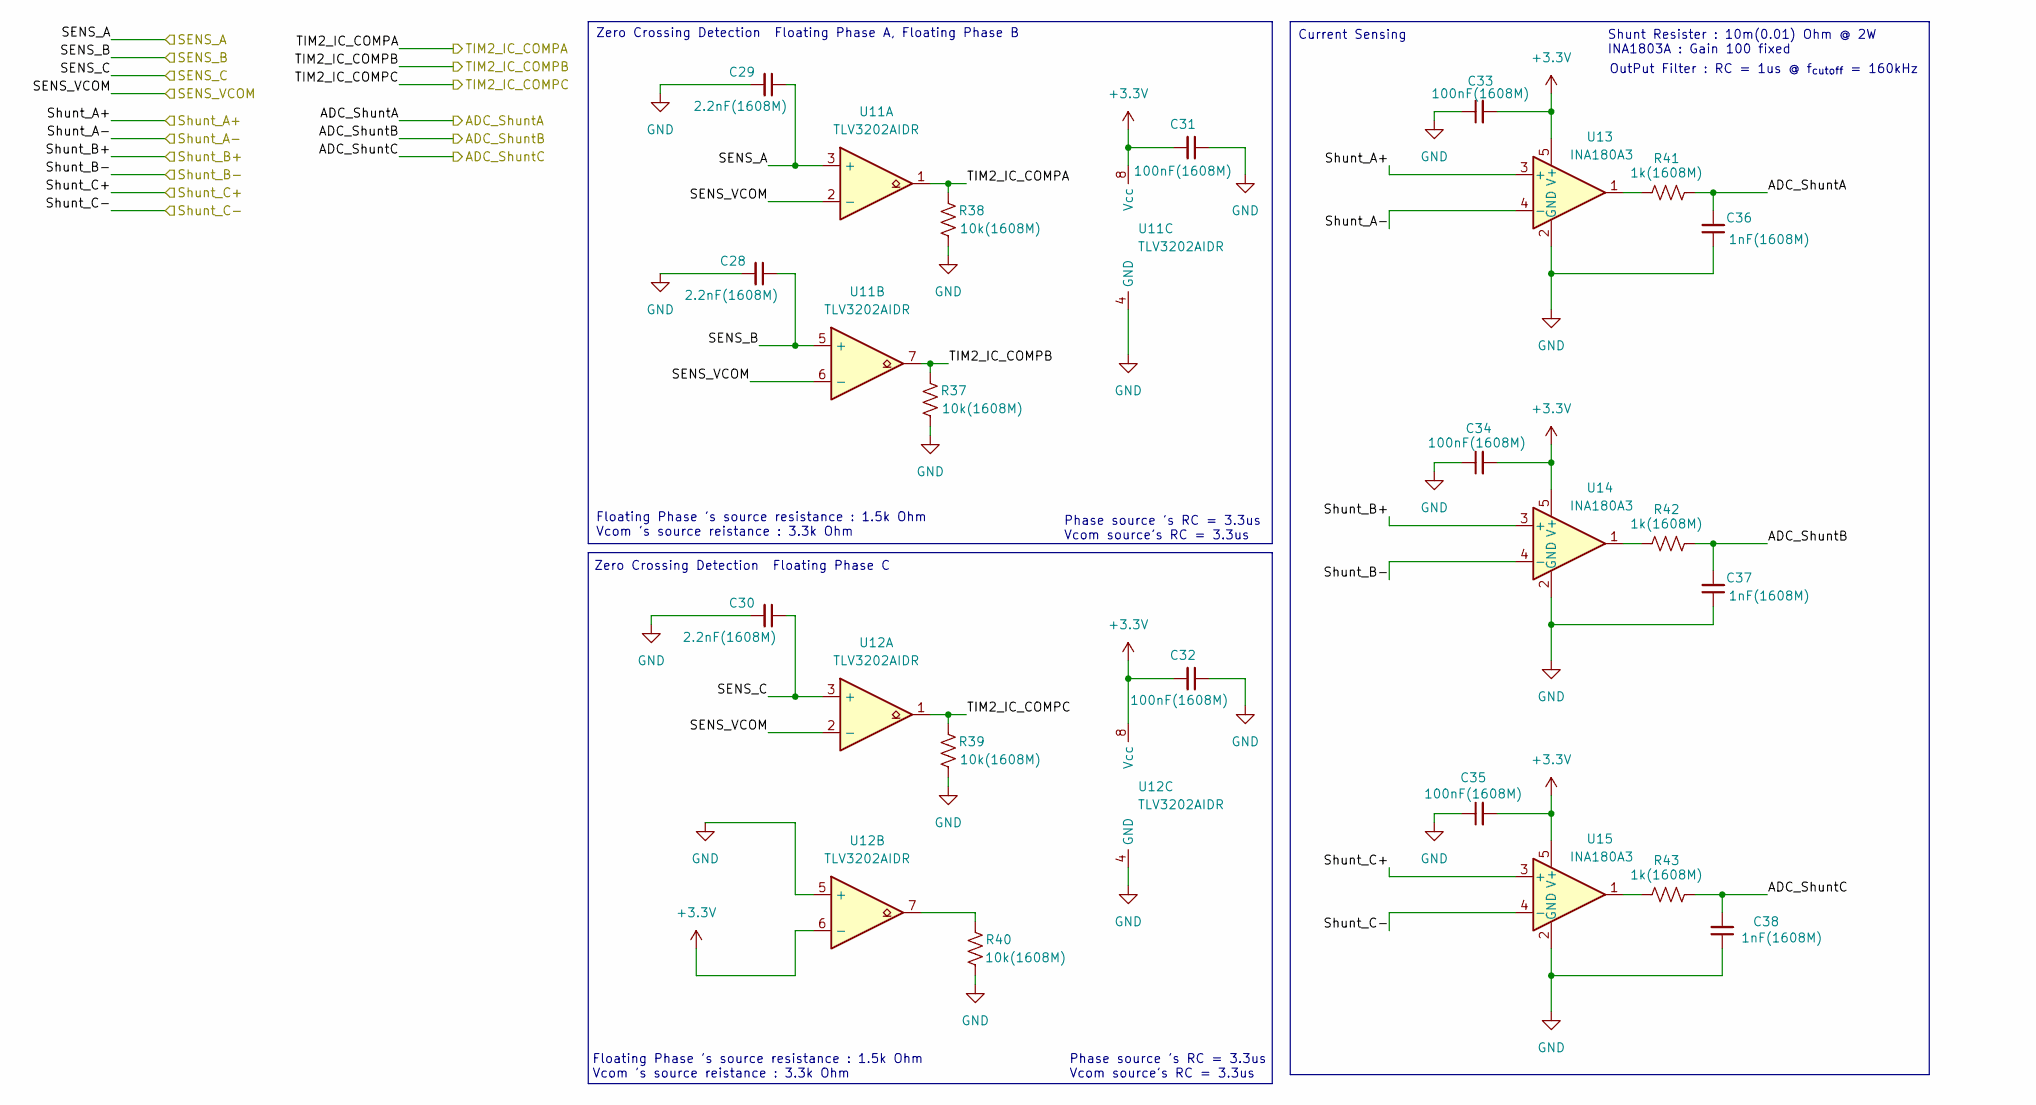
[picture p23: schematic sensing_block.kicad_sch, BLDC Motor ESC]

Parts:
C28, C29, C30: 2.2nF(1608M); C_0603_1608Metric; Part number CL10B222KB8NNNC
C31, C32, C33, C34, C35: 100nF(1608M); C_0603_1608Metric; Part number GRM188R71H104KA93D
C36, C37, C38: 1nF(1608M); C_0603_1608Metric; Part number CL10B102KB8NNNC
R37, R38, R39, R40: 10k(1608M); R_0603_1608Metric; Part number 0603WAF1002T5E
R41, R42, R43: 1k(1608M); R_0603_1608Metric; Part number 0603WAF1001T5E
U11, U12: TLV3202AIDR; SOIC-8_3.9x4.9mm_P1.27mm; Part number TLV3202AIDR
U13, U14, U15: INA180A3; SOT-23-5; Part number INA180A3IDBVR

Connections:
+3.3V: C31.2, C32.2, C33.2, C34.2, C35.2, U11.8 (Vcc), U12.6 (-), U12.8 (Vcc), U13.5 (V+), U14.5 (V+), U15.5 (V+); also elsewhere on the board
/Inverter_BLOCK/SENS_A: C29.1, U11.3 (+); also elsewhere on the board
/Inverter_BLOCK/SENS_B: C28.1, U11.5 (+); also elsewhere on the board
/Inverter_BLOCK/SENS_C: C30.1, U12.3 (+); also elsewhere on the board
/Inverter_BLOCK/SENS_VCOM: U11.2 (-), U11.6 (-), U12.2 (-); also elsewhere on the board
/Inverter_BLOCK/Shunt_A+: U13.3 (+); also elsewhere on the board
/Inverter_BLOCK/Shunt_B+: U14.3 (+); also elsewhere on the board
/Inverter_BLOCK/Shunt_C+: U15.3 (+); also elsewhere on the board
/MCU_BLOCK/ADC_ShuntA: C36.2, R41.2; also elsewhere on the board
/MCU_BLOCK/ADC_ShuntB: C37.2, R42.2; also elsewhere on the board
/MCU_BLOCK/ADC_ShuntC: C38.2, R43.2; also elsewhere on the board
/MCU_BLOCK/TIM2_IC_COMPA: R38.1, U11.1; also elsewhere on the board
/MCU_BLOCK/TIM2_IC_COMPB: R37.1, U11.7; also elsewhere on the board
/MCU_BLOCK/TIM2_IC_COMPC: R39.1, U12.1; also elsewhere on the board
GND: C28.2, C29.2, C30.2, C31.1, C32.1, C33.1, C34.1, C35.1, C36.1, C37.1, C38.1, R37.2, R38.2, R39.2, R40.2, U11.4 (GND), U12.4 (GND), U12.5 (+), U13.2 (GND), U13.4 (-), U14.2 (GND), U14.4 (-), U15.2 (GND), U15.4 (-); also elsewhere on the board
unnamed: R40.1, U12.7
unnamed: R41.1, U13.1
unnamed: R42.1, U14.1
unnamed: R43.1, U15.1

Notes on the sheet:
Shunt Resister : 10m(0.01) Ohm @ 2W INA1803A : Gain 100 fixed
Zero Crossing Detection Floating Phase A, Floating Phase B
Phase source 's RC = 3.3us Vcom source's RC = 3.3us
Zero Crossing Detection Floating Phase C
Floating Phase 's source resistance : 1.5k Ohm Vcom 's source reistance : 3.3k Ohm
Current Sensing
OutPut Filter : RC = 1us @ f_{cutoff} = 160kHz

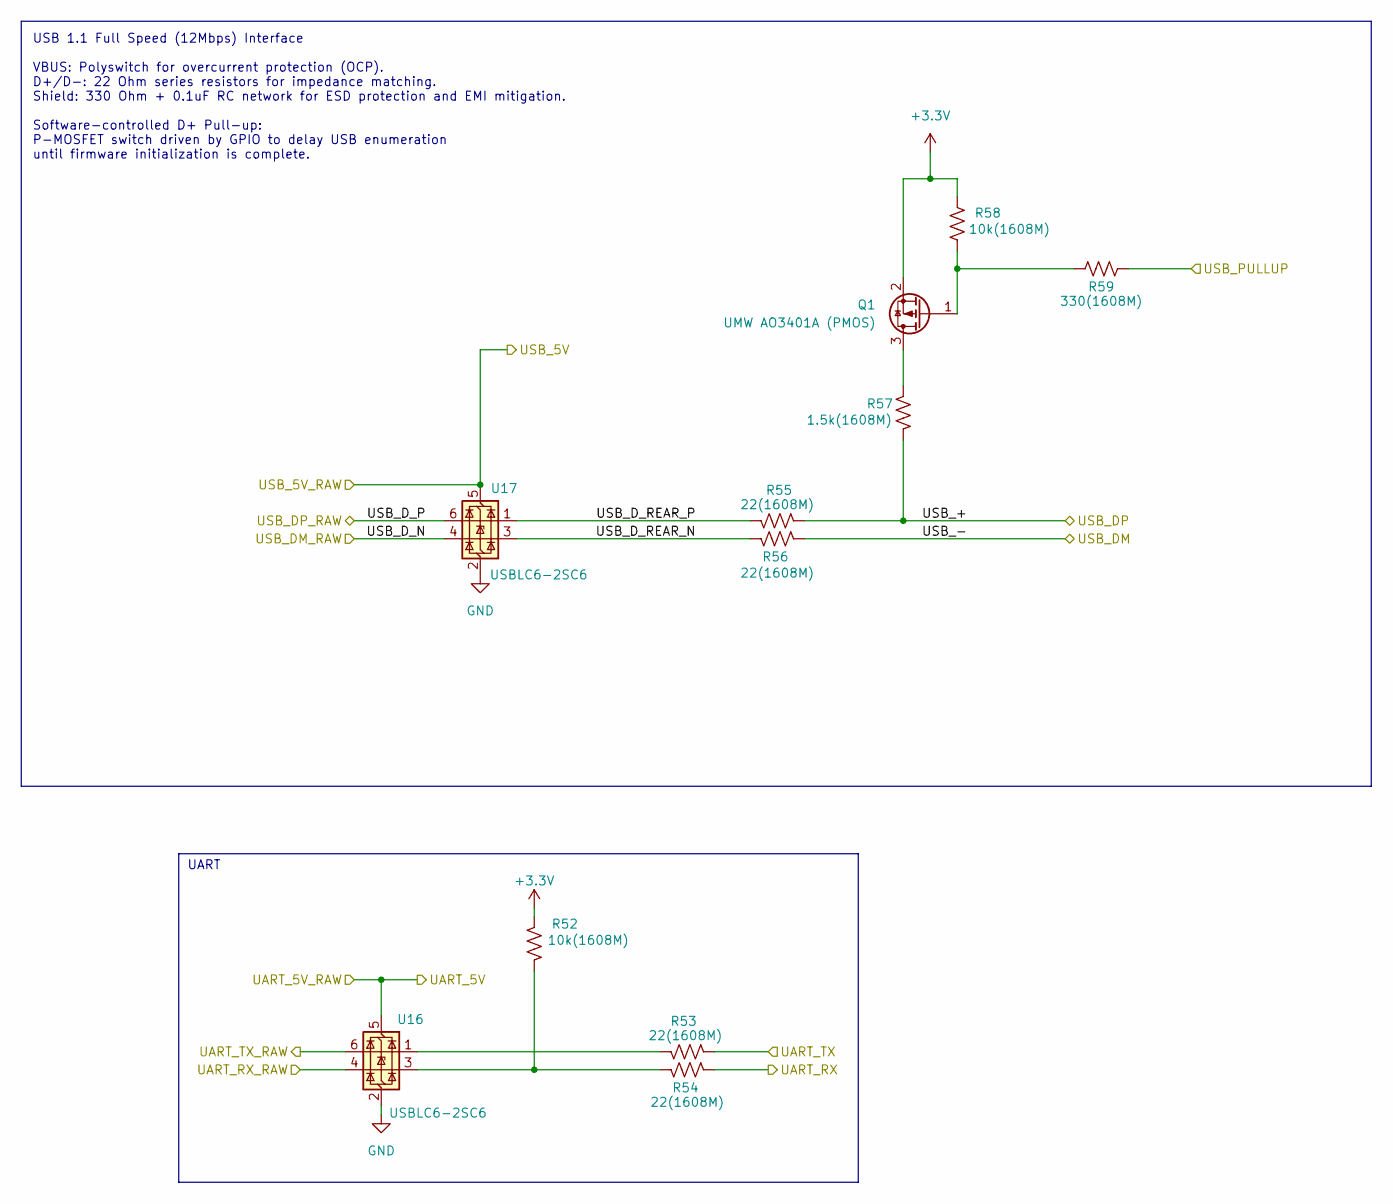
[picture p24: schematic comm_block.kicad_sch, BLDC Motor ESC]

Parts:
Q1: UMW AO3401A (PMOS); SOT-23; Part number AO3401A
R52, R58: 10k(1608M); R_0603_1608Metric; Part number 0603WAF1002T5E
R53, R54, R55, R56: 22(1608M); R_0603_1608Metric; Part number 0603WAF220JT5E
R57: 1.5k(1608M); R_0603_1608Metric; Part number 0603WAF1501T5E
R59: 330(1608M); R_0603_1608Metric; Part number 0603WAF3300T5E
U16, U17: USBLC6-2SC6; SOT-23-6; Part number USBLC6-2SC6

Connections:
+3.3V: Q1.2 (S), R52.1, R58.1; also elsewhere on the board
/COMM_BLOCK/UART_RX_RAW: U16.4 (I/O2); also elsewhere on the board
/COMM_BLOCK/UART_TX_RAW: U16.6 (I/O1); also elsewhere on the board
/COMM_BLOCK/USB_+: R55.1, R57.2; also elsewhere on the board
/COMM_BLOCK/USB_-: R56.1; also elsewhere on the board
/COMM_BLOCK/USB_D_N: U17.4 (I/O2); also elsewhere on the board
/COMM_BLOCK/USB_D_P: U17.6 (I/O1); also elsewhere on the board
/COMM_BLOCK/USB_D_REAR_N: R56.2, U17.3 (I/O2)
/COMM_BLOCK/USB_D_REAR_P: R55.2, U17.1 (I/O1)
/MCU_BLOCK/UART1_Rx: R54.1; also elsewhere on the board
/MCU_BLOCK/UART1_Tx: R53.1; also elsewhere on the board
/MCU_BLOCK/USB_DP_PullUp: R59.1; also elsewhere on the board
/POWER_BLOCK/UART_5V: U16.5 (VBUS); also elsewhere on the board
/POWER_BLOCK/USB_5V: U17.5 (VBUS); also elsewhere on the board
GND: U16.2 (GND), U17.2 (GND); also elsewhere on the board
unnamed: Q1.3 (D), R57.1
unnamed: Q1.1 (G), R58.2, R59.2
unnamed: R52.2, R54.2, U16.3 (I/O2)
unnamed: R53.2, U16.1 (I/O1)

Notes on the sheet:
USB 1.1 Full Speed (12Mbps) Interface VBUS: Polyswitch for overcurrent protection (OCP). D+/D-: 22 Ohm series resistors for impedance matching. Shield: 330 Ohm + 0.1uF RC network for ESD protection and EMI mitigation. Software-controlled D+ Pull-up: P-MOSFET switch driven by GPIO to delay USB enume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
UART

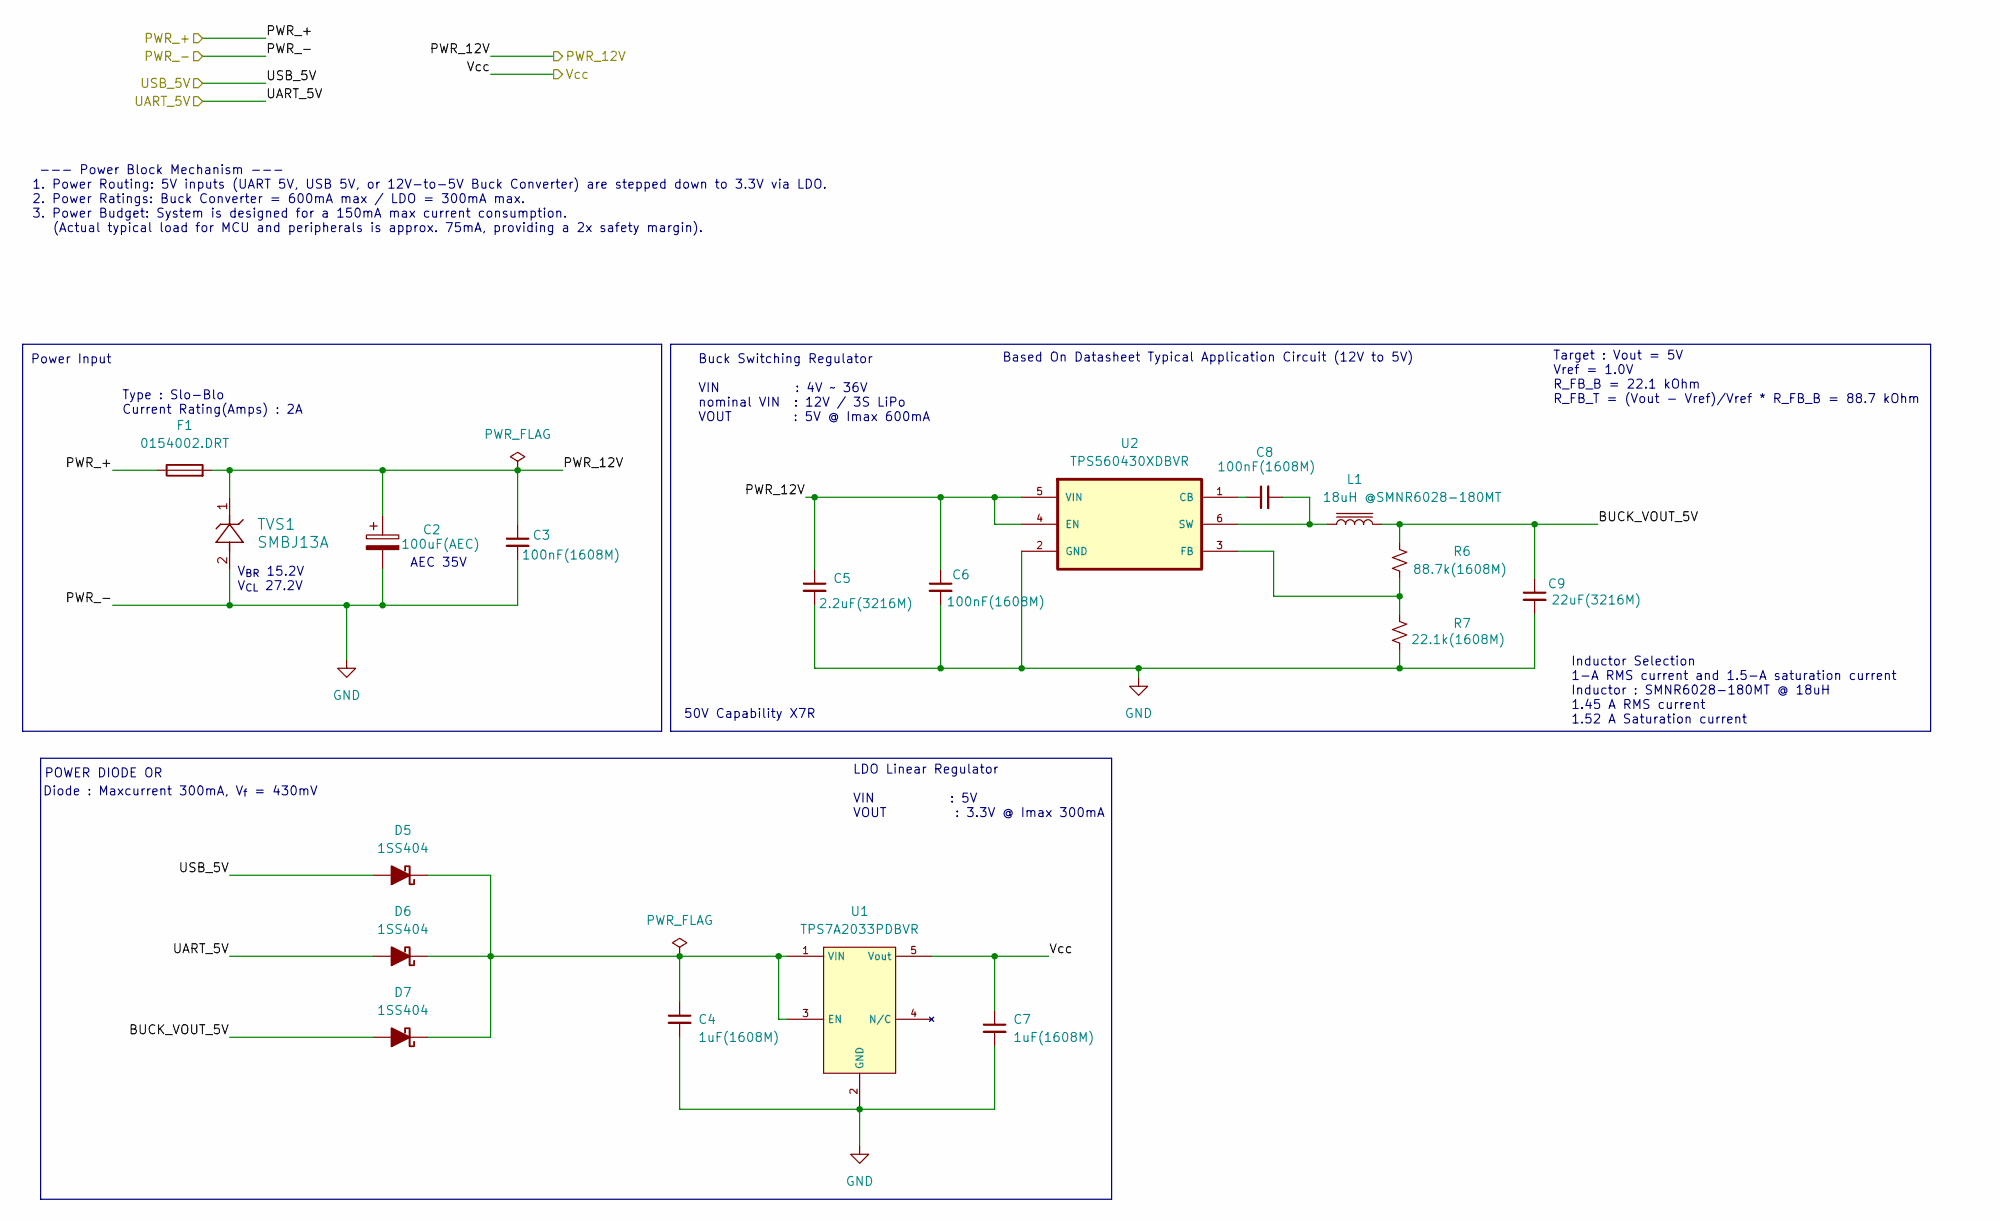
[picture p25: schematic power_block.kicad_sch, BLDC Motor ESC]

Parts:
C2: 100uF(AEC); CP_Elec_6.3x7.7; Part number RVT1V101M0607
C3, C6, C8: 100nF(1608M); C_0603_1608Metric; Part number GRM188R71H104KA93D
C4, C7: 1uF(1608M); C_0603_1608Metric; Part number CL10A105KA8NNNC
C5: 2.2uF(3216M); C_1206_3216Metric; Part number GRM31CR71H225KA88L
C9: 22uF(3216M); C_1206_3216Metric; Part number GRM31CR71A226KE15L
D5, D6, D7: 1SS404; D_SOD-323; Part number 1SS404
F1: 0154002.DRT; FUSE_154 Series OMNI-BLOK® Fuse and Holder Assembly; Part number 0154002.DRT
L1: 18uH @SMNR6028-180MT; Inductor SMNR6028-180MT; Part number SMNR6028-180MT
R6: 88.7k(1608M); R_0603_1608Metric; Part number 0603WAF8872T5E
R7: 22.1k(1608M); R_0603_1608Metric; Part number 0603WAF2212T5E
TVS1: SMBJ13A; TVS_Diode_SMD_SMB(DO-214AA); Part number SMBJ13A-TR
U1: TPS7A2033PDBVR; SOT-23-5; Part number TPS7A2033PDBVR
U2: TPS560430XDBVR; SOT-23-6(2.90 mm × 1.60 mm); Part number TPS560430XDBVR

Connections:
+3.3V: C7.1, U1.5 (Vout); also elsewhere on the board
+12V: C2.1, C3.1, C5.1, C6.1, F1.2, TVS1.1, U2.4 (EN), U2.5 (VIN); also elsewhere on the board
/POWER_BLOCK/BUCK_VOUT_5V: C9.1, D7.2 (A), L1.2, R6.2
/POWER_BLOCK/PWR_+: F1.1; also elsewhere on the board
/POWER_BLOCK/UART_5V: D6.2 (A); also elsewhere on the board
/POWER_BLOCK/USB_5V: D5.2 (A); also elsewhere on the board
GND: C2.2, C3.2, C4.2, C5.2, C6.2, C7.2, C9.2, R7.1, TVS1.2, U1.2 (GND), U2.2 (GND); also elsewhere on the board
unnamed: C4.1, D5.1 (K), D6.1 (K), D7.1 (K), U1.1 (VIN), U1.3 (EN)
unnamed: C8.1, U2.1 (CB)
unnamed: R6.1, R7.2, U2.3 (FB)
unnamed: C8.2, L1.1, U2.6 (SW)

Notes on the sheet:
Diode : Maxcurrent 300mA, V_{f} = 430mV
Based On Datasheet Typical Application Circuit (12V to 5V)
Target : Vout = 5V Vref = 1.0V R_FB_B = 22.1 kOhm R_FB_T = (Vout - Vref)/Vref * R_FB_B = 88.7 kOhm
Buck Switching Regulator VIN : 4V ~ 36V nominal VIN : 12V / 3S LiPo VOUT : 5V @ Imax 600mA
Inductor Selection 1-A RMS current and 1.5-A saturation current Inductor : SMNR6028-180MT @ 18uH 1.45 A RMS current 1.52 A Saturation current
50V Capability X7R
Type : Slo-Blo Current Rating(Amps) : 2A
Power Input
LDO Linear Regulator VIN : 5V VOUT : 3.3V @ Imax 300mA
POWER DIODE OR
--- Power Block Mechanism --- 1. Power Routing: 5V inputs (UART 5V, USB 5V, or 12V-to-5V Buck Converter) are stepped down to 3.3V via LDO. 2. Power Ratings: Buck Converter = 600mA max / LDO = 300mA max. 3. Power Budget: System is designed for a 150mA max current consumption. (Actual typical load fo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
AEC 35V
V_{BR} 15.2V V_{CL} 27.2V
