cej830/STM32_BLDC_ESC_Firmware/HardWare/STM32_ESC_HW.kicad_pcb

## KiCad design HardWare/STM32_ESC_HW.kicad_pcb (continued)

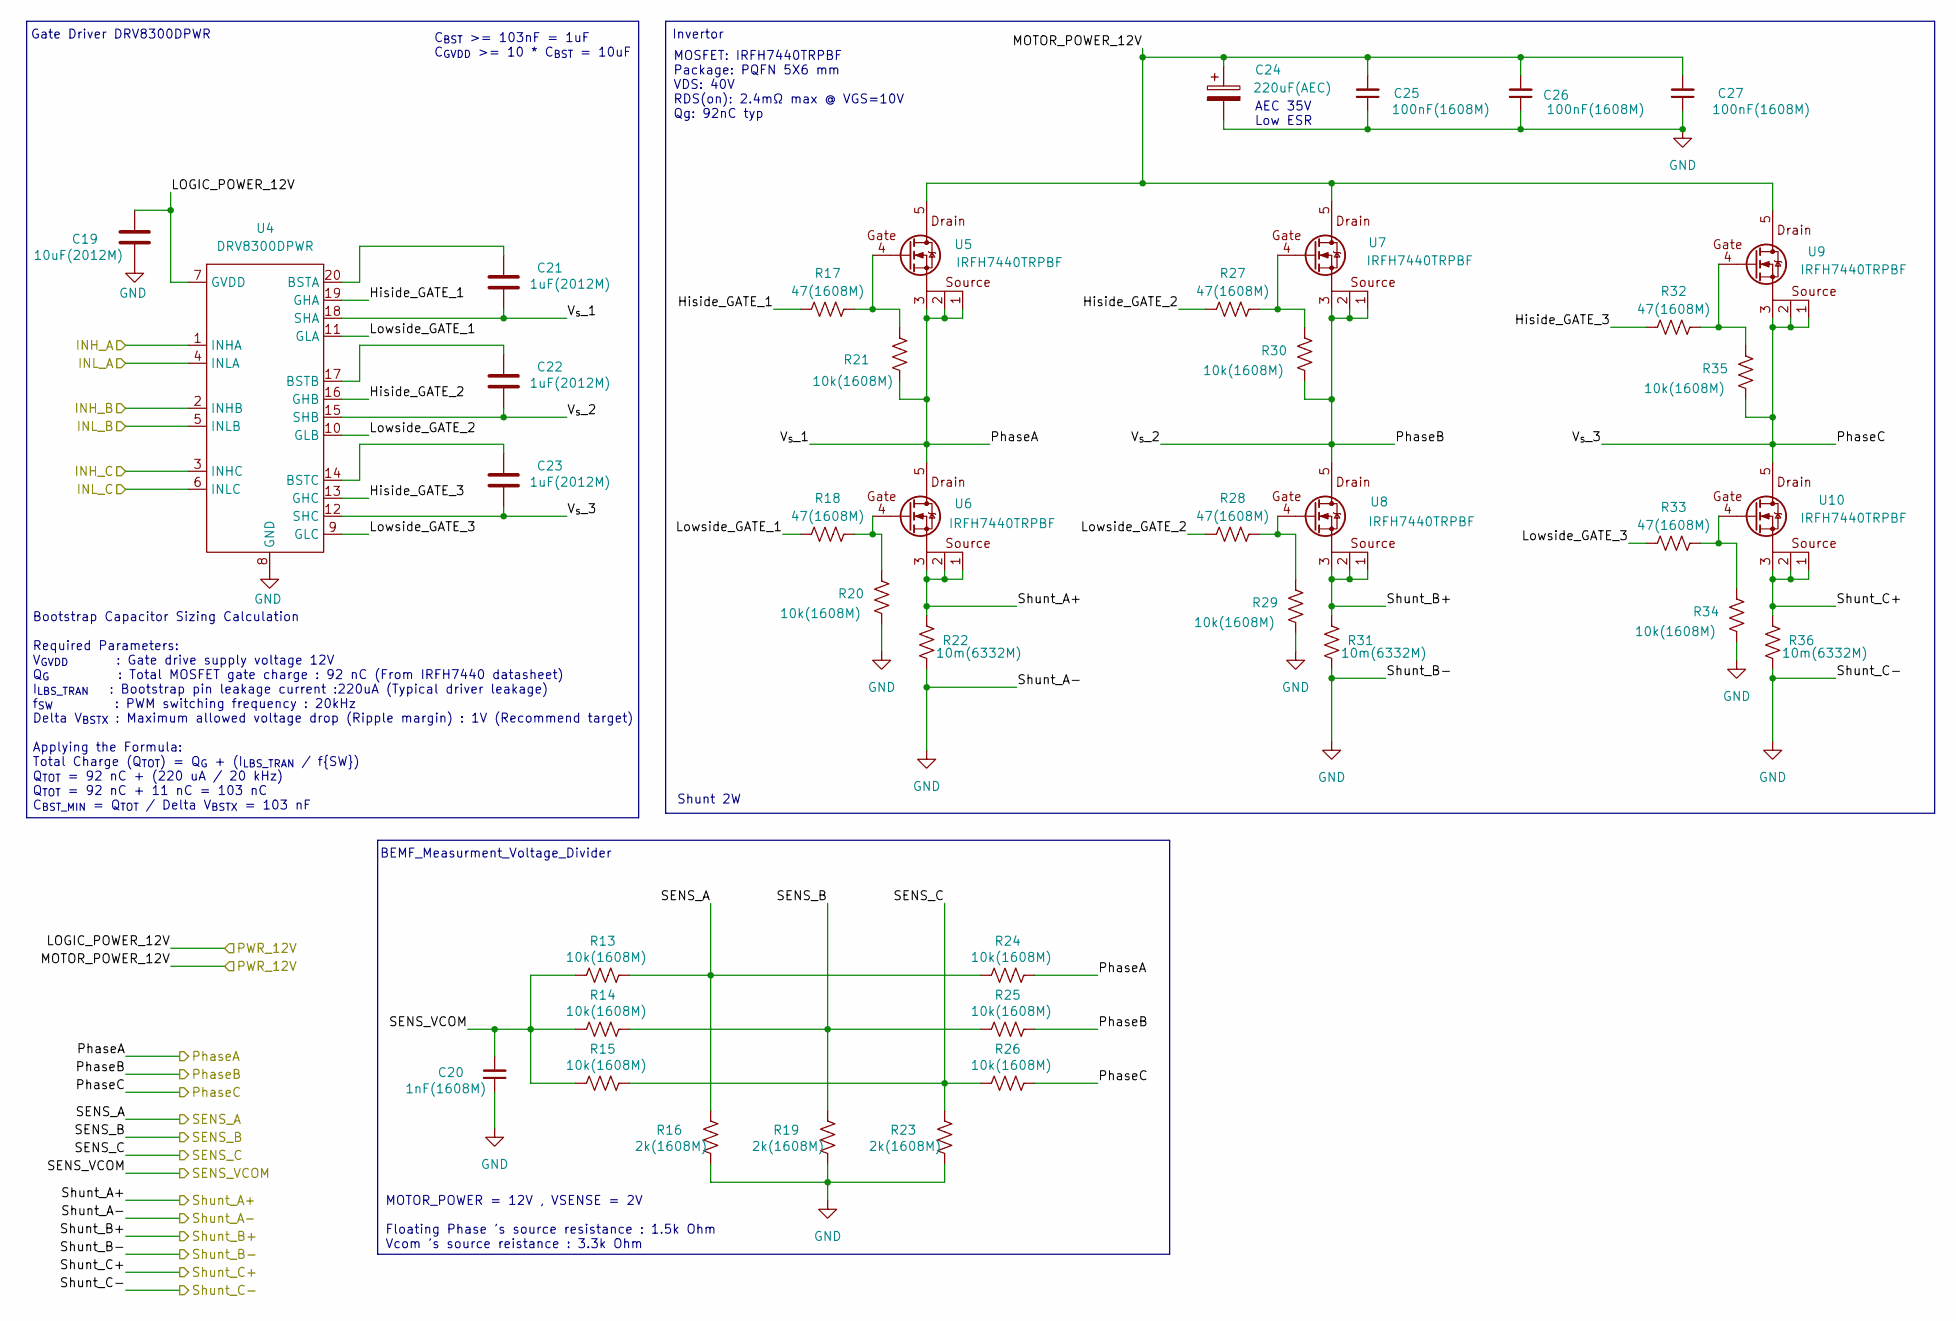
[picture p26: schematic inverter_block.kicad_sch, BLDC Motor ESC]

Parts:
C19: 10uF(2012M); C_0805_2012Metric; Part number CL21A106KAYNNNE
C20: 1nF(1608M); C_0603_1608Metric; Part number CL10B102KB8NNNC
C21, C22, C23: 1uF(2012M); C_0805_2012Metric; Part number CL21B105KAFNFNE
C24: 220uF(AEC); CP_Elec_8x10.5; Part number RVT1V221M0810
C25, C26, C27: 100nF(1608M); C_0603_1608Metric; Part number GRM188R71H104KA93D
R13, R14, R15, R20, R21, R24, R25, R26, R29, R30, R34, R35: 10k(1608M); R_0603_1608Metric; Part number 0603WAF1002T5E
R16, R19, R23: 2k(1608M); R_0603_1608Metric; Part number 0603WAF2001T5E
R17, R18, R27, R28, R32, R33: 47(1608M); R_0603_1608Metric; Part number 0603WAF470JT5E
R22, R31, R36: 10m(6332M); Shunt_R_PE2512_7m-910m Ohm_SMD_2512; Part number PE2512FKE7W0R01Z
U4: DRV8300DPWR; DRV8300DPWR 20-TSSOP 6.6mm _ 4.5mm; Part number DRV8300DPWR
U5, U6, U7, U8, U9, U10: IRFH7440TRPBF; PQFN-8-EP_6x5mm_P1.27mm_Generic; Part number IRFH7440TRPBF

Connections:
+12V: C19.1, C24.1, C25.2, C26.2, C27.2, U4.7 (GVDD), U5.5, U7.5, U9.5; also elsewhere on the board
/Inverter_BLOCK/Hiside_GATE_1: R17.1, U4.19 (GHA)
/Inverter_BLOCK/Hiside_GATE_2: R27.1, U4.16 (GHB)
/Inverter_BLOCK/Hiside_GATE_3: R32.1, U4.13 (GHC)
/Inverter_BLOCK/Lowside_GATE_1: R18.1, U4.11 (GLA)
/Inverter_BLOCK/Lowside_GATE_2: R28.1, U4.10 (GLB)
/Inverter_BLOCK/Lowside_GATE_3: R33.1, U4.9 (GLC)
/Inverter_BLOCK/PhaseA: C21.1, R21.2, R24.2, U4.18 (SHA), U5.1, U5.2, U5.3, U6.5; also elsewhere on the board
/Inverter_BLOCK/PhaseB: C22.1, R25.2, R30.2, U4.15 (SHB), U7.1, U7.2, U7.3, U8.5; also elsewhere on the board
/Inverter_BLOCK/PhaseC: C23.1, R26.2, R35.2, U4.12 (SHC), U9.1, U9.2, U9.3, U10.5; also elsewhere on the board
/Inverter_BLOCK/SENS_A: R13.2, R16.2, R24.1; also elsewhere on the board
/Inverter_BLOCK/SENS_B: R14.2, R19.2, R25.1; also elsewhere on the board
/Inverter_BLOCK/SENS_C: R15.2, R23.2, R26.1; also elsewhere on the board
/Inverter_BLOCK/SENS_VCOM: C20.2, R13.1, R14.1, R15.1; also elsewhere on the board
/Inverter_BLOCK/Shunt_A+: R22.1, U6.1, U6.2, U6.3; also elsewhere on the board
/Inverter_BLOCK/Shunt_B+: R31.1, U8.1, U8.2, U8.3; also elsewhere on the board
/Inverter_BLOCK/Shunt_C+: R36.1, U10.1, U10.2, U10.3; also elsewhere on the board
/MCU_BLOCK/PWM_CH1: U4.1 (INHA); also elsewhere on the board
/MCU_BLOCK/PWM_CH1N: U4.4 (INLA); also elsewhere on the board
/MCU_BLOCK/PWM_CH2: U4.2 (INHB); also elsewhere on the board
/MCU_BLOCK/PWM_CH2N: U4.5 (INLB); also elsewhere on the board
/MCU_BLOCK/PWM_CH3: U4.3 (INHC); also elsewhere on the board
/MCU_BLOCK/PWM_CH3N: U4.6 (INLC); also elsewhere on the board
GND: C19.2, C20.1, C24.2, C25.1, C26.1, C27.1, R16.1, R19.1, R20.2, R22.2, R23.1, R29.2, R31.2, R34.2, R36.2, U4.8 (GND); also elsewhere on the board
unnamed: R17.2, R21.1, U5.4
unnamed: R18.2, R20.1, U6.4
unnamed: R27.2, R30.1, U7.4
unnamed: R28.2, R29.1, U8.4
unnamed: R32.2, R35.1, U9.4
unnamed: R33.2, R34.1, U10.4
unnamed: C21.2, U4.20 (BSTA)
unnamed: C22.2, U4.17 (BSTB)
unnamed: C23.2, U4.14 (BSTC)

Notes on the sheet:
BEMF_Measurment_Voltage_Divider
Floating Phase 's source resistance : 1.5k Ohm Vcom 's source reistance : 3.3k Ohm
MOTOR_POWER = 12V , VSENSE = 2V
AEC 35V Low ESR
MOSFET: IRFH7440TRPBF Package: PQFN 5X6 mm VDS: 40V RDS(on): 2.4mΩ max @ VGS=10V Qg: 92nC typ
Shunt 2W
Invertor
C_{BST} >= 103nF = 1uF C_{GVDD} >= 10 * C_{BST} = 10uF
Bootstrap Capacitor Sizing Calculation Required Parameters: V_{GVDD} : Gate drive supply voltage 12V Q_{G} : Total MOSFET gate charge : 92 nC (From IRFH7440 datasheet) I_{LBS_TRAN} : Bootstrap pin leakage current :220uA (Typical driver leakage) f_{SW} : PWM switching frequency : 20kHz Delta V_{BSTX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
Gate Driver DRV8300DPWR

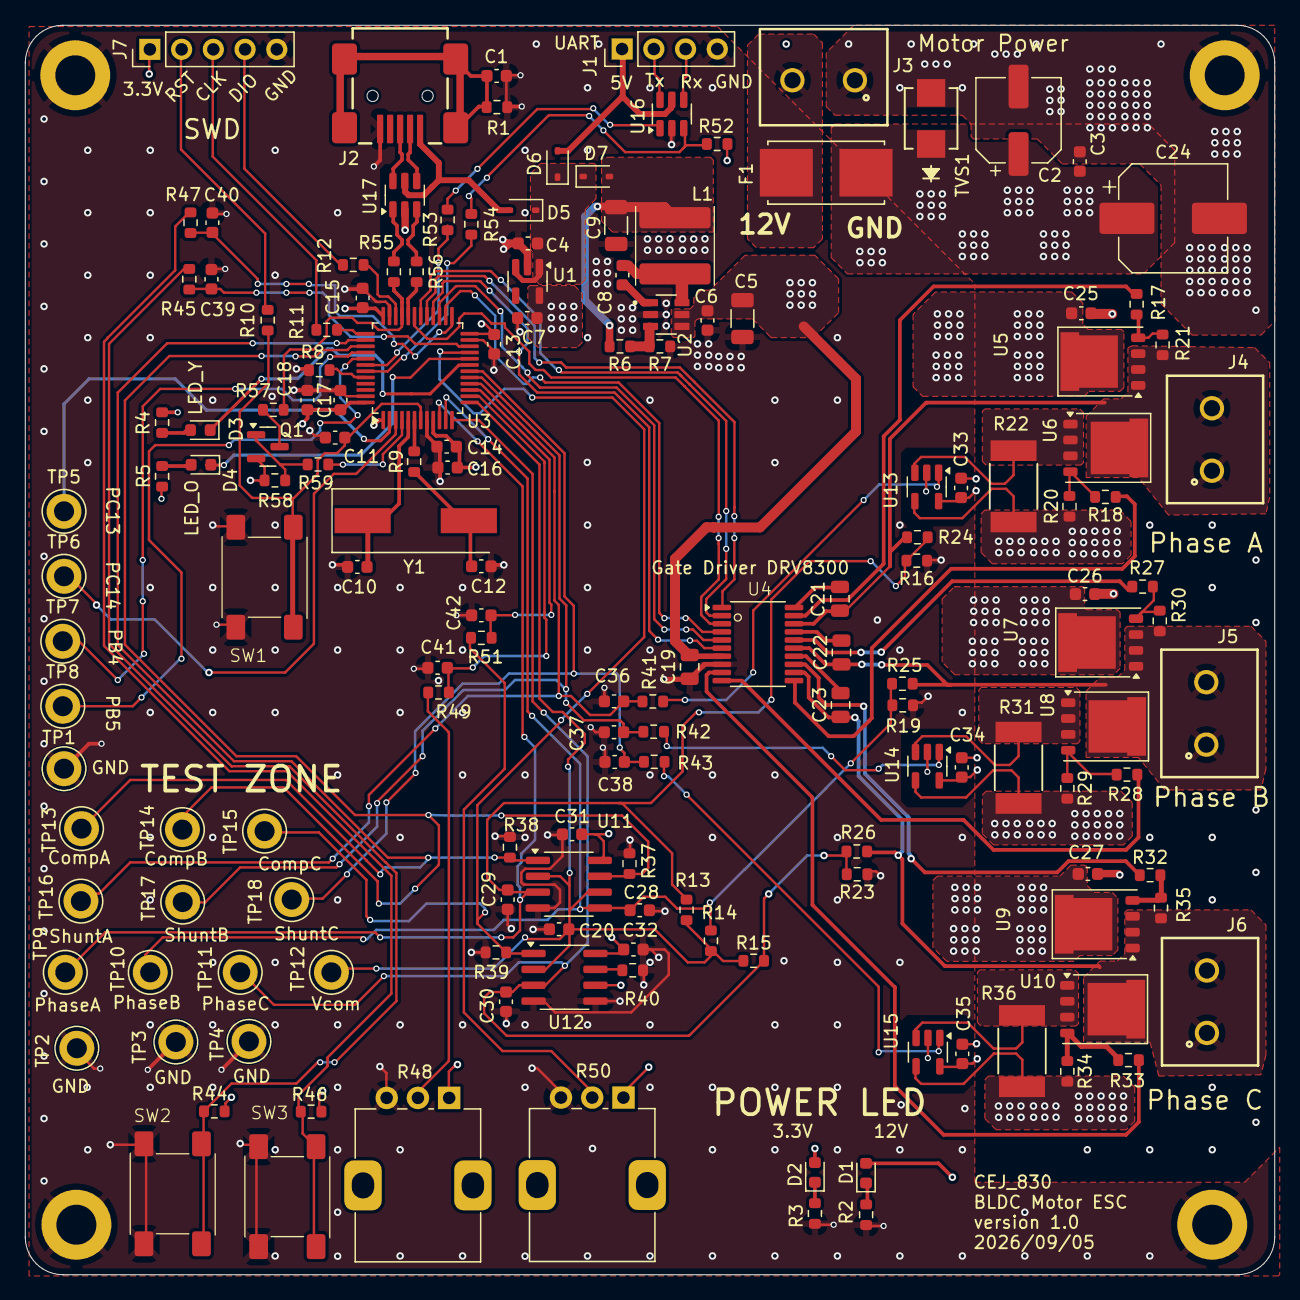
[picture p27: board STM32_ESC_HW.kicad_pcb from above]

Board: 4 copper layers, 100.0 x 100.0 mm, 162 parts (0 on the bottom side), 96 nets.
