cej830/STM32_BLDC_ESC_Firmware/Core/Src/main.c

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
/* Includes ------------------------------------------------------------------*/
#include "main.h"
#include "usb_device.h"

/* USER CODE BEGIN Includes */
#include <my_Utility/utility_Log_BLDC.h>

#include <layer_0_Driver/driver_ADC_Potentiometer.h>
#include <layer_0_Driver/driver_BLDC_HW.h>
#include <layer_0_Driver/driver_GateDriver.h>
#include <layer_0_Driver/driver_UART.h>

#include <layer_1_Algorithm/algorithm_BLDC_Control.h>
#include <layer_1_Algorithm/algorithm_ADC_Control.h>
#include <layer_1_Algorithm/algorithm_Compartor.h>

#include <layer_2_Service/service_BLDC.h>
#include <layer_2_Service/service_UART.h>
/* USER CODE END Includes */

ADC_HandleTypeDef hadc1;
ADC_HandleTypeDef hadc2;
DMA_HandleTypeDef hdma_adc1;

TIM_HandleTypeDef htim1;
TIM_HandleTypeDef htim2;
TIM_HandleTypeDef htim3;
TIM_HandleTypeDef htim4;

UART_HandleTypeDef huart1;

void SystemClock_Config(void);
static void MX_GPIO_Init(void);
static void MX_DMA_Init(void);
static void MX_TIM1_Init(void);
static void MX_USART1_UART_Init(void);
static void MX_ADC1_Init(void);
static void MX_TIM2_Init(void);
static void MX_TIM3_Init(void);
static void MX_ADC2_Init(void);
static void MX_TIM4_Init(void);
/**
  * @brief  The application entry point.
  * @retval int
  */
int main(void)
{

  /* MCU Configuration--------------------------------------------------------*/

  /* Reset of all peripherals, Initializes the Flash interface and the Systick. */
  HAL_Init();

  /* Configure the system clock */
  SystemClock_Config();

  /* Initialize all configured peripherals */
  MX_GPIO_Init();
  MX_DMA_Init();
  MX_TIM1_Init();
  MX_USART1_UART_Init();
  MX_ADC1_Init();
  MX_TIM2_Init();
  MX_TIM3_Init();
  MX_ADC2_Init();
  MX_TIM4_Init();
  /* USER CODE BEGIN 2 */
  GPIO_InitTypeDef GPIO_InitStruct = {0};
  __HAL_RCC_GPIOA_CLK_ENABLE();
  GPIO_InitStruct.Pin = GPIO_PIN_12;
  GPIO_InitStruct.Mode = GPIO_MODE_OUTPUT_PP;
  GPIO_InitStruct.Speed = GPIO_SPEED_FREQ_LOW;
  HAL_GPIO_Init(GPIOA, &GPIO_InitStruct);

  HAL_GPIO_WritePin(GPIOA, GPIO_PIN_12, RESET);
  HAL_Delay(100);

  MX_USB_DEVICE_Init();
  HAL_GPIO_DeInit(GPIOA, GPIO_PIN_12);

  // LED 끄기
  HAL_GPIO_WritePin(LED_ORANGE_GPIO_Port, LED_ORANGE_Pin, SET);
  HAL_GPIO_WritePin(LED_YELLOW_GPIO_Port, LED_YELLOW_Pin, SET);

  /* ADC 페리페럴 관련 초기화 */
  HAL_ADCEx_Calibration_Start(&hadc1);
  HAL_ADCEx_Calibration_Start(&hadc2);

  HAL_ADCEx_InjectedStart(&hadc2);
  HAL_ADCEx_InjectedStart_IT(&hadc1);

  Driver_Init_Potentiometer();	//HAL_ADCEx_MultiModeStart_DMA 를 통해, 버퍼주소를 넘겨준다
  Driver_Init_Us_Timer();
  Driver_Init_GateDriver();
  Driver_BLDC_HW_Init();

  Algo_BLDC_Init();
  Robust_Static_Init(220);
  Init_Comparator();

  Create_LogRingBuffer();

  Service_BLDC_Init();
  Service_Init_UART();

  HAL_NVIC_SetPriority(USB_LP_CAN1_RX0_IRQn, 3, 0);



  HAL_Delay(30);
  /* USER CODE END 2 */

  /* Infinite loop */
  /* USER CODE BEGIN WHILE */
  while (1)
  {
    /* USER CODE END WHILE */

    /* USER CODE BEGIN 3 */
	//Service_UART_RunCLI();
 	Service_BLDC_Run();
 	Service_Telemetry_Run();
 	Polling_Conversion_Target();

  }
  /* USER CODE END 3 */
}

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
