cej830/STM32_BLDC_ESC_Firmware/(commit log)

2026-10-02 BLDC FW Backup
    [CloseLoop_Log_Debug_Exp_1.csv, CloseLoop_Log_Debug_Exp_2.csv, CloseLoop_Log_Debug_Exp_3.csv, CloseLoop_Log_Debug_Exp_4.csv, CloseLoop_Log_Debug_Exp_5.csv, CloseLoop_Log_Debug_Exp_6.csv, CloseLoop_Log_Debug_Exp_7.csv, CloseLoop_Log_Debug_Exp_8.csv]
2026-10-03 Monitor Program Basic
    [bldc_MANUAL_STOP_20261003_180848.csv, bldc_MANUAL_STOP_20261003_180858.csv, bldc_MANUAL_STOP_20261003_181115.csv, bldc_MANUAL_STOP_20261003_181326.csv, bldc_MANUAL_STOP_20261003_181332.csv, bldc_MANUAL_STOP_20261003_181402.csv, bldc_MANUAL_STOP_20261003_181420.csv, bldc_MANUAL_STOP_20261003_181443.csv]
2026-10-03 Monitor Program Add RPM
    [bldc_cycle100_MANUAL_STOP_20261003_192522.csv, bldc_cycle100_MANUAL_STOP_20261003_192526.csv, bldc_cycle100_MANUAL_STOP_20261003_192530.csv, bldc_cycle100_MANUAL_STOP_20261003_192532.csv, bldc_cycle100_MANUAL_STOP_20261003_192533.csv, bldc_cycle100_MANUAL_STOP_20261003_192535.csv, bldc_raw600_MANUAL_STOP_20261003_192522.csv, bldc_raw600_MANUAL_STOP_20261003_192526.csv]
2026-10-03 BLDC Add ZC_Valid
    [bldc_raw600_MANUAL_STOP_20261004_010040.csv, bldc_raw600_MANUAL_STOP_20261004_011713.csv, bldc_raw600_MANUAL_STOP_20261004_011756.csv, bldc_seq100_summary_20261004_010042.csv, bldc_seq100_summary_20261004_011703.csv, bldc_seq100_summary_20261004_011738.csv, bldc_seq100_summary_20261004_011757.csv]
2026-10-04 BLDC FW Add Change SampleMode
    [bldc_raw600_MOTOR_STOP_TIMEOUT_20261004_015247.csv, bldc_raw600_MOTOR_STOP_TIMEOUT_20261004_113027.csv, bldc_raw600_MOTOR_STOP_TIMEOUT_20261004_130643.csv, bldc_raw600_MOTOR_STOP_TIMEOUT_20261004_130826.csv, bldc_seq100_summary_20261004_112705.csv, bldc_seq100_summary_20261004_112746.csv, bldc_seq100_summary_20261004_112757.csv, bldc_seq100_summary_20261004_112817.csv]
2026-10-04 BLDC FW Add ZC_ALREADY
    [bldc_raw600_MOTOR_STOP_TIMEOUT_20261004_175336.csv, bldc_raw600_MOTOR_STOP_TIMEOUT_20261004_180056.csv, bldc_raw600_MOTOR_STOP_TIMEOUT_20261004_191511.csv, bldc_seq100_summary_20261004_191237.csv, bldc_seq100_summary_20261004_191310.csv, bldc_seq100_summary_20261004_191546.csv]
2026-10-04 BLDC FW Add ADC ISR StateMachine
    [bldc_raw600_MANUAL_STOP_20261004_213428.csv, bldc_raw600_MANUAL_STOP_20261004_213924.csv, bldc_raw600_MOTOR_STOP_TIMEOUT_20261004_213719.csv, bldc_raw600_MOTOR_STOP_TIMEOUT_20261004_213809.csv, bldc_raw600_MOTOR_STOP_TIMEOUT_20261004_213934.csv, bldc_raw600_MOTOR_STOP_TIMEOUT_20261004_215155.csv, bldc_raw600_MOTOR_STOP_TIMEOUT_20261004_215905.csv, bldc_raw600_MOTOR_STOP_TIMEOUT_20261004_220410.csv]
2026-10-04 BLDC FW Add Poten CCR
    [bldc_raw600_MANUAL_STOP_20261005_000258.csv, bldc_raw600_MOTOR_STOP_TIMEOUT_20261005_000351.csv, bldc_raw600_MOTOR_STOP_TIMEOUT_20261005_000647.csv, bldc_raw600_MOTOR_STOP_TIMEOUT_20261005_015016.csv, bldc_raw600_MOTOR_STOP_TIMEOUT_20261005_015347.csv, bldc_seq100_summary_20261005_000216.csv, bldc_seq100_summary_20261005_000431.csv, bldc_seq100_summary_20261005_000609.csv]
2026-10-08 BLDC FW Stable CCR 1400
    [CloseLoop_Log_Debug_Exp_1.csv, CloseLoop_Log_Debug_Exp_2.csv, CloseLoop_Log_Debug_Exp_3.csv, CloseLoop_Log_Debug_Exp_4.csv, CloseLoop_Log_Debug_Exp_5.csv, CloseLoop_Log_Debug_Exp_6.csv, CloseLoop_Log_Debug_Exp_7.csv, CloseLoop_Log_Debug_Exp_8.csv]
2026-10-11 BLDC FW Add CompShodow
2026-10-12 BLDC FW Mix ADC COMP
2026-10-15 Senserless ESC FW v1
2026-10-15 Sensorless ESC FW Add Monitor
2026-10-18 BLDC FW Add Readme
2026-10-23 BLDC ESC Add Readme
2026-10-27 BLDC Project V1
2026-11-04 BLDC ESC porject 1104
2026-11-08 BLDC ESC 1109
2026-11-08 BLDC ESC FW F
