cej830/STM32_BLDC_ESC_Firmware/Images/PCB2.jpg

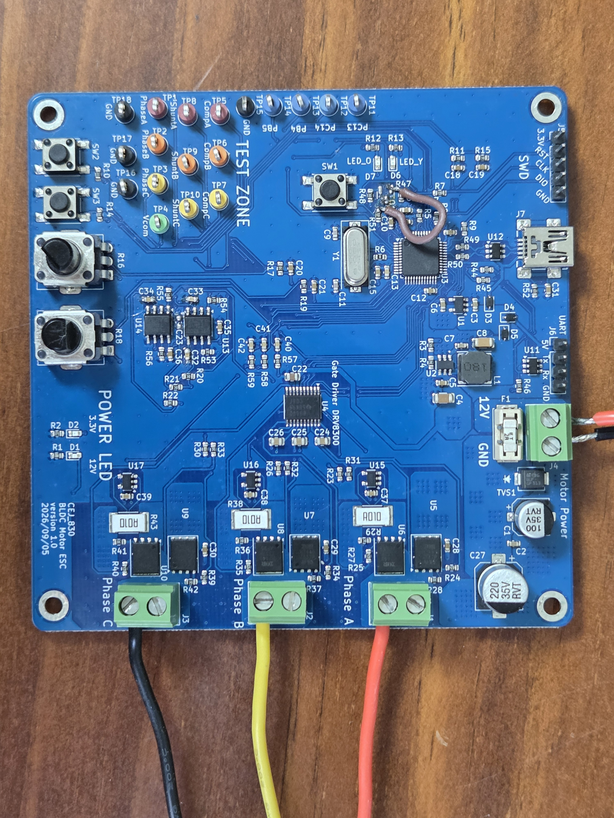
Images/PCB2.jpg
