cej830/STM32_BLDC_ESC_Firmware/Images/PCB.jpg

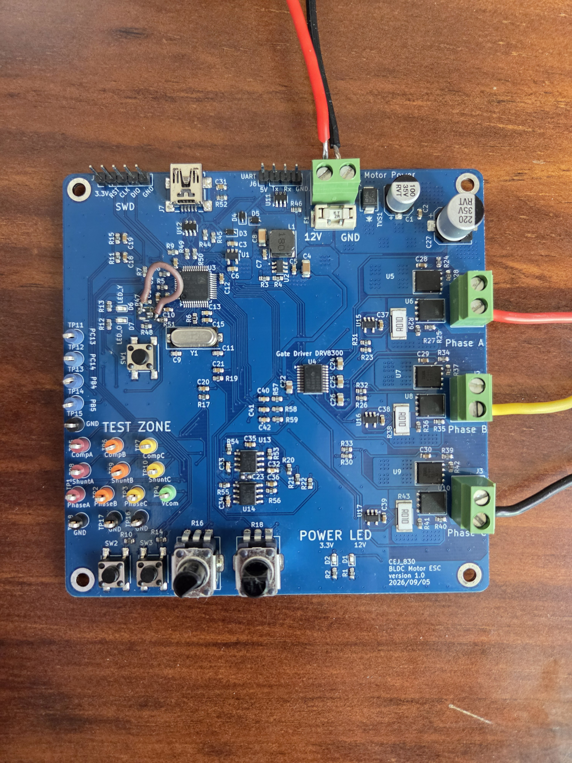
Images/PCB.jpg
